marcospiana/termopago/docs/TermoPago_Proyecto_Completo.docx

TermoPago

Documento maestro del proyecto — v2

Contexto completo y actualizado para retomar en una conversación nueva.

Actualizado: agosto 2026 · Autor: Marcos — Concordia, Entre Ríos

Backend: web-production-94bbab.up.railway.app · Dominio: termopago.com.ar

Repo (público): github.com/marcospiana/termopago · Mail: contacto@termopago.com.ar

# Contenido

# 1. Qué es TermoPago

Sistema IoT de cobro que activa máquinas de autoservicio cuando el cliente paga con un QR de MercadoPago. El cliente escanea el QR pegado en la máquina, paga desde el celular (cualquier billetera/app bancaria), y el equipo arranca solo por el tiempo pagado, sin cajero ni efectivo.

Sirve para aspiradoras, sopladores, termos, infladores, lavaderos — cualquier equipo que se active por tiempo o por pulso. Convive con las fichas (no reemplaza el monedero: le suma un medio de pago).

Estado: funcionando con pagos reales. Termo + 2 estaciones (aspiradora + soplador cada una). El circuito pago → activación funciona; el QR se re-arma solo; hay reembolso automático y respaldo por fichas.

# 2. Arquitectura ACTUAL: maestro–esclavo (2 ESP)

El cambio más importante desde la v1. Cada estación se divide en dos ESP para que un servicio pago NUNCA se corte por problemas de WiFi:

- MAESTRO (ESP32): solo hace WiFi + backend. Poll ea los pagos y, cuando entra uno, le manda al esclavo por UART el comando "activá canal X por Y segundos". NO tiene relé ni LCD, así que no se puede colgar por el bus del display.
- ESCLAVO (ESP32 o ESP8266): maneja el RELÉ, el TIEMPO del servicio y el CONTADOR en pantalla. Cuenta el tiempo con su propio reloj. Como no hace WiFi, casi nunca se reinicia — y si el maestro pierde WiFi o se reinicia, el esclavo SIGUE dando el servicio hasta el final.

Enlace entre los dos: un cable UART (TX del maestro → RX del esclavo) + GND común. El maestro va afuera (buena señal); el esclavo va en la máquina (con el relé y el display).

## Protocolo maestro → esclavo (UART, 9600)

- "1<texto>" / "2<texto>": líneas del display en REPOSO (las manda el maestro).
- "A,<canal>,<seg>,<orden>": ACTIVAR un canal. El esclavo ignora un orden repetido (dedup), así un reinicio del maestro no re-activa el mismo pago.

El display en servicio lo dibuja el ESCLAVO (tiene el temporizador); en reposo muestra el texto del maestro.

# 3. Firmware — archivos y qué hace cada uno

Carpeta (firmware/) | Qué es
estacion01_maestro | ESP32 maestro est.01 (IDs aspiradora01/soplado01). Incluye BSSID-lock a 2.4GHz de Home3523.
estacion01_esclavo | NodeMCU ESP8266: relé + display + tiempo. RX=D7, relés D5/D6, LCD SDA=D2/SCL=D1.
estacion02_maestro | ESP32 maestro est.02 (IDs aspiradora02/soplado02).
estacion02_esclavo | ESP32: relé + display + tiempo. RX=GPIO16, relés 25/26, LCD 21/22.
prueba_1esp_busclear | Variante de UN ESP (LCD por I2C a 2m con bus-clear). Guardada para prueba futura.
test_lcd_esp8266 | Diagnóstico: escáner I2C + test de LCD para el ESP8266.
test_scan_wifi | Diagnóstico: escanea redes 2.4GHz (BSSID/canal/RSSI) desde el lugar.
termopago_esp32_v3 | Firmware del TERMO (1 relé + LCD, un solo ESP).

## Conexiones maestro–esclavo (recordatorio)

- Est.02 (2x ESP32): maestro GPIO17 → esclavo GPIO16; GND común. Relés en el esclavo GPIO25/26. LCD al esclavo SDA21/SCL22.
- Est.01 (ESP32 + ESP8266): maestro GPIO17 → esclavo D7(GPIO13); GND común. Relés en el esclavo D5(GPIO14)/D6(GPIO12). LCD SDA=D2(GPIO4)/SCL=D1(GPIO5).
- IMPORTANTE: fuente 5V SEPARADA para el esclavo (solo GND en común), + cap 3300µF + 0.1µF en cada ESP.

# 4. Fixes de confiabilidad aplicados

- Watchdog que SÍ reinicia: se usa esp_task_wdt_reconfigure con trigger_panic (antes solo avisaba, no reseteaba). Comprobado: rescata cuelgues reales.
- Se quitó el watchdog por timer: causaba reinicios cada 90s (833 'Watchdog interrupt' en /reinicios). Eliminado.
- Reconexión WiFi sin portal: si pierde WiFi, reintenta la red guardada y reinicia limpio; nunca queda esperando configuración (era lo que lo dejaba muerto).
- Doble consulta: recién tras 2 ciclos de polling fallados muestra 'Sin conexión al servidor' (evita el parpadeo por un bache).
- LCD robusto: reintento de init al arrancar + recuperación física del bus I2C (9 pulsos) + reinit diferido tras conmutar el relé + Wire.setTimeOut.
- HTTPS: setInsecure + connect timeout, para que un server caído no cuelgue el equipo.
- BSSID-lock (est.01): clavado a la radio 2.4GHz del router doble banda para evitar el band-steering a 5GHz (que hacía colgar y reiniciar). LOCK_BSSID + LOCK_CHANNEL en el maestro.

# 5. Backend (app.py)

- Flask + gunicorn en Railway. app.py en la RAÍZ (Railway deploya de ahí). PostgreSQL. Deploy automático desde main.
- Zona horaria AR (UTC-3) con ahora_ar() en todo.
- MercadoPago Orders API v1. QR estático por caja. Orden vence PT15M, se re-arma con el polling.
- Reembolso automático de pagos no atendidos (~5 min). Retoma con tiempo restante tras corte de luz. Monto mínimo QR: $50.

## Variables en Railway

Variable | Contenido
MP_ACCESS_TOKEN | Token de la cuenta propia (termo)
MP_TOKEN_ASPIRADORA | Token del cliente de las estaciones
CLAVE_SECRETA | Clave de las URLs del panel
PRECIO / DATABASE_URL | Precio por defecto / PostgreSQL
MP_CLIENT_ID / SECRET / FEE_PORCENTAJE | Futuras: OAuth marketplace (comisión)

# 6. Páginas del panel de control

Reemplazar TU_CLAVE por CLAVE_SECRETA. Base: web-production-94bbab.up.railway.app (o termopago.com.ar).

Página | URL | Para qué
Estado | /estado/TU_CLAVE | Estado en vivo de cada equipo (verde/amarillo/rojo)
Cortes | /cortes/TU_CLAVE | Bajones de conexión >30s por día
Reinicios ⭐NUEVO | /reinicios/TU_CLAVE | Por qué se reinició cada ESP (watchdog/pico/corte/WiFi) + cuánto estuvo activo + ID del equipo
Historial | /historial/TU_CLAVE | Movimientos: día, hora, máquina, monto, estado
Estadísticas | /estadisticas/TU_CLAVE | Ventas por día, mes y máquina
Config | /config/TU_CLAVE | Precio y tiempo de cada máquina
Simular pago | /simular_pago/TU_CLAVE/SEG/ID | Prueba sin dinero
Re-armar QR | /rearmar/TU_CLAVE/ID | Re-armar un QR vencido
Crear máquina | /crear_dispositivo/TU_CLAVE/ID/NOMBRE/VAR_TOKEN | Alta de una máquina nueva
Diagnóstico | /diagnostico/TU_CLAVE | Credenciales MP, cajas, datos crudos
Landing | / | Página pública (clientes)

/reinicios y /boot: el ESP reporta al arrancar en /boot/<id>/<motivo> (esp_reset_reason). La página /reinicios muestra la causa (corte-luz, software, wdt-task, brownout-elec, etc.) con el ID del equipo (aspiradora01 vs aspiradora02) para distinguir estaciones.

# 7. Diagnóstico y aprendizajes clave

- Est.01 se reiniciaba por band-steering: el router Home3523 (doble banda) la empujaba a 5GHz → la WiFi se volvía inestable → se colgaba. Solución: clavar el ESP a la radio 2.4GHz por BSSID. RESUELTO.
- Est.02 tiene señal floja (-75 dBm) vía repetidor: el repetidor (TP-Link TL-WR850N, solo 2.4) está lejos. Solución pendiente: acercar el repetidor / antena externa (WROOM-32U) / módulo 4G.
- Display en blanco al conectar WiFi = ALIMENTACIÓN: el tirón de corriente del WiFi baja la tensión de la fuente compartida y apaga el esclavo/LCD. Solución: fuente 5V SEPARADA por ESP + cap 3300µF + 0.1µF pegados a cada ESP.
- Cuelgue al apagar la máquina = pico de la bobina del contactor: solución: snubber RC en las bobinas (A1-A2). Un MOV ayuda pero no alcanza solo.
- La instrumentación (/reinicios) es oro: permite ver la causa exacta de cada falla en vez de adivinar. Fue lo que localizó el bug del watchdog por timer.

# 8. Máquinas activas

Máquina | ID | Caja MP | Relé | Estación
Termo | termo_001 | 1486831 | — | Propia (sin ESP por ahora)
Aspiradora 01 | aspiradora01 | 135130132 | canal 0 | Est.01 (Home3523)
Soplador 01 | soplado01 | 135136662 | canal 1 | Est.01
Aspiradora 02 | aspiradora02 | 135700091 | canal 0 | Est.02 (repetidor)
Soplador 02 | soplado02 | 135700133 | canal 1 | Est.02

# 9. Cómo armar un dispositivo para OTRO cliente

Pasos completos para sumar una estación de un cliente nuevo:

1. MercadoPago del cliente: el cliente crea su aplicación en MP y te pasa su Access Token. (Vos no ingresás sus credenciales en ningún lado por él.)
2. Cargar el token en Railway como una variable nueva (ej. MP_TOKEN_CLIENTEX). NUNCA en el código (el repo es público).
3. Crear la(s) máquina(s) en el backend: /crear_dispositivo/TU_CLAVE/ID/NOMBRE/MP_TOKEN_CLIENTEX. Devuelve la caja MP y el link del QR. El ID no debe tener espacios y debe coincidir con el firmware.
4. Imprimir el QR de cada máquina (el link que devuelve, o de /diagnostico) y pegarlo en la máquina.
5. Hardware por estación: 1 ESP32 (maestro) + 1 ESP32/ESP8266/Arduino Nano (esclavo) + módulo relé + LCD + 2 fuentes 5V (separadas) + caps 3300µF+0.1µF + snubbers en las bobinas + caja IP65.
6. Firmware: copiá estacion0X_maestro y estacion0X_esclavo, cambiá los IDs por los del cliente y el nombre del portal WiFi. Si la red del cliente es doble banda, poné el BSSID-lock (escaneá con test_scan_wifi para sacar BSSID/canal).
7. Cargar el maestro (ESP32 Dev Module) y el esclavo. Conectar según el mapa de pines. Configurar el WiFi (portal WiFiManager la primera vez).
8. Probar: simular un pago (/simular_pago) y verificar que el relé active y el contador aparezca. Después, un pago real.
9. Comisión (opcional): activar OAuth marketplace cuando corresponda (MP_CLIENT_ID/SECRET/FEE_PORCENTAJE + /oauth_callback).

Checklist eléctrico anti-cuelgue: fuente separada para el esclavo, caps pegados, snubber en cada bobina de contactor/electroválvula, cableado de señales lejos de los 220V, gabinete a tierra.

# 10. Futuro: arquitectura LoRa (sitios con varias máquinas)

Para un sitio con varias máquinas separadas (sin cablear), la evolución natural del maestro-esclavo: UNA central con internet que le avisa a cada máquina por radio LoRa. Elimina el WiFi por equipo.

- Central (1 por sitio): ESP32 con internet (Ethernet vía WT32-ETH01, o 4G, o WiFi) + LoRa 915MHz. Poll ea/escucha el backend y reparte comandos por LoRa.
- Nodos (1 por máquina): ESP32/Arduino + módulo LoRa 915MHz + relé + TU LCD (no hace falta la OLED). Es el mismo esclavo, con LoRa en vez de UART y un ID de nodo.
- Placa recomendada: Heltec WiFi LoRa 32 V3 (915MHz) — ESP32+LoRa+OLED integrados. O ESP32/Arduino + módulo SX1262 915MHz si querés sin pantalla.
- Direccionamiento: cada nodo tiene un ID; el comando lleva el ID destino (A|nodo|canal|seg|orden); cada nodo filtra por su ID.
- ACK: LoRa es bidireccional → el nodo confirma que recibió la orden; el maestro reintenta si no hay ACK, y recién ahí confirma el pago (/completar). Cierra el hueco de 'plata sin servicio'. + heartbeat para el estado en vivo.
- Push en vez de polling: con MQTT, MercadoPago avisa al backend (webhook) y el backend publica el pago → la central lo recibe al instante, sin preguntar cada 3s. (+ poll de respaldo cada 30-60s.)
- 50m entre estaciones = trivial para LoRa. 1 central + N nodos, todas placas iguales.

# 11. Seguridad y pendientes

- Tokens y CLAVE_SECRETA SOLO en variables de Railway, nunca en el código (repo público). El BSSID en el código no es secreto (es una MAC visible).
- ACCESOS_privado.txt / *_privado.txt en .gitignore, NUNCA se comitean. Gestor de contraseñas pendiente (Bitwarden).
- Pendientes est.02: fuente separada + caps, señal (repetidor/antena/4G), snubbers.
- Pendientes generales: activar OAuth marketplace; estadísticas propias del cliente; recargo por crédito (listo para agregar); prototipo LoRa cuando lleguen las placas.

# 12. Cómo continuar en una conversación nueva

Subí este .docx al inicio de la conversación nueva y pegá algo así:

Estoy desarrollando TermoPago: sistema IoT que activa máquinas de autoservicio (aspiradoras, sopladores) al pagar con QR de MercadoPago. Backend Flask en Railway con PostgreSQL; los equipos son ESP32 en arquitectura maestro-esclavo (el maestro hace WiFi+backend, el esclavo maneja relé+tiempo+display, así el servicio no se corta si el maestro pierde WiFi). Te adjunto el documento maestro con TODO el contexto (arquitectura, firmware, fixes, páginas del panel, cómo armar para un cliente nuevo, y el plan LoRa). Leélo y ayudame a seguir con: [DECIME EN QUÉ AVANZAR].

No olvidar: tokens y clave SOLO en Railway (repo público); app.py en la raíz; fuente separada + caps + snubber en cada estación nueva.
