marcospiana/termopago/docs/TermoPago_Resumen_Tecnico.docx

TermoPago

Sistema de cobro automático para servicios físicos

Marcos Piana — Concordia, Entre Ríos — Mayo 2026

# ¿Qué es TermoPago?

Sistema IoT que permite cobrar automáticamente por servicios físicos (agua caliente, inflado, aspirado) mediante un código QR y MercadoPago. El cliente escanea el QR con la cámara del celular, paga, y el relé se activa automáticamente por el tiempo configurado. Sin atención humana requerida.

# Arquitectura del sistema

## Flujo completo

• Cliente escanea QR físico con la cámara del celular

• QR apunta a: https://web-production-94bbab.up.railway.app/crear_pago

• El backend Flask genera una preferencia de pago en MercadoPago y redirige

• Cliente paga con débito o cuenta MercadoPago

• MercadoPago envía un webhook POST al backend con la confirmación

• Backend guarda una orden pendiente en la base de datos

• El ESP8266 consulta el backend cada 3 segundos vía HTTP GET

• Si hay orden pendiente → activa el relé por el tiempo configurado

• El LCD muestra cuenta regresiva en tiempo real

## Stack tecnológico

Componente | Tecnología / Detalle
Microcontrolador | NodeMCU ESP8266 (migración a ESP32 pendiente)
Backend | Python Flask hosteado en Railway
Base de datos | SQLite (migración a PostgreSQL pendiente)
Pagos | MercadoPago — solo débito y cuenta MP
Display | LCD 16x2 con I2C (hd44780 de Bill Perry, dirección 0x27)
Relé | 1 canal, lógica invertida (LOW=ON, HIGH=OFF)
WiFi setup | WiFiManager — red 'TermoPago' para configurar sin código
QR | Generado en goqr.me — URL fija, nunca cambia
Repositorio | github.com/marcospiana/termopago

# Hardware

## Componentes actuales

Componente | Detalle
NodeMCU ESP8266 | Microcontrolador principal
Relé 1 canal | Lógica invertida. Conectado a 3.3V (no VIN — causa activación involuntaria)
LCD 16x2 I2C | Dirección 0x27. Alimentado con 5V externo, NO del NodeMCU
Fuente 5V externa | Para el LCD

## Conexiones

Relé: IN → D1 | VCC → 3.3V | GND → GND

LCD: VCC → 5V externo | GND → GND | SDA → D2 | SCL → D3

## Hardware pendiente de compra

• ESP32 DevKit V1 38 pines — reemplaza el ESP8266

• Relé con optoacoplador 5V 1 canal

• Fuente industrial 220V → 5V 2A

• Buck converter LM2596 (para alimentar desde 24V)

• Caja estanca IP65 + borneras atornillables

• Buzzer activo 5V (beep al activarse el servicio)

• DFPlayer Mini + parlante + microSD (audio futuro)

• Waveshare ESP32-S3 Relay 6CH (para múltiples servicios)

# Backend Flask

## URL de producción

https://web-production-94bbab.up.railway.app

## Rutas disponibles

Ruta | Descripción
GET /orden/<dispositivo_id> | El ESP consulta si hay orden pendiente. Retorna encender y segundos
GET /simular_pago/termo2026$ | Simula un pago aprobado para pruebas
POST /webhook | Recibe notificaciones de MercadoPago
GET /crear_pago | Genera preferencia de pago y redirige al checkout de MP
GET /historial | Últimas 20 órdenes ejecutadas

## Variables de entorno en Railway

Variable | Descripción
MP_ACCESS_TOKEN | Token productivo de MercadoPago (APP_USR-...)
CLAVE_SECRETA | termo2026$ — protege la ruta de simulación de pago
PRECIO | 500 (ARS, configurable sin tocar código)

# Problemas de confiabilidad identificados

## 🔴 Crítico — SQLite en Railway

Railway borra la base de datos en cada redeploy. Una orden pendiente puede desaparecer antes de que el ESP la ejecute, causando que el cliente pague y el servicio no se active.

Solución: Migrar a PostgreSQL integrado de Railway (pendiente).

## 🟡 Importante — Firmware del ESP

• Sin watchdog timer: si el ESP se cuelga, no se recupera solo

• Sin lógica de reconexión WiFi: si cae el WiFi, el loop sigue sin hacer nada

• Posible memory leak: http.getString() sin liberar puede colgar el dispositivo después de horas

## ✅ Lo que ya está bien

• Polling cada 3 segundos es robusto y simple — no se cambia a WebSockets por priorizar confiabilidad

• WiFiManager permite reconfigurar WiFi sin tocar el código (resetear: RST x3 en menos de 10 segundos)

• Webhook de MercadoPago es el mecanismo confiable de notificación de pagos

• QR definitivo — la URL nunca cambia aunque cambie el precio

# Decisiones de arquitectura tomadas

Decisión | Razonamiento
Polling 3s en vez de WebSockets | Simplicidad y tolerancia a fallos. La latencia de 3s es aceptable para un servicio de 30 minutos
ESP32 en vez de Raspberry Pi | RPi puede corromper la SD en cortes de luz. ESP32 arranca en 2 segundos y es más confiable 24/7
Flask + Railway en vez de serverless | Webhook de MP requiere servidor persistente, no funciones efímeras
SQLite → PostgreSQL | SQLite en Railway no es persistente entre deploys. PostgreSQL es obligatorio para producción
Solo débito y cuenta MP | Elimina el riesgo de pagos en efectivo (rapipago, pagofacil) que complican el flujo

# Modelo de negocio

• El dueño del local instala y paga el hardware (~$50-80 USD)

• Marcos instala, configura y cobra comisión por transacción (5-10%)

• Implementación futura: MercadoPago Marketplace — el cliente autoriza su cuenta via OAuth

• Split automático del pago: X% para el local, Y% para Marcos

• Facturación automática futura via API de AFIP

# Próximos pasos priorizados

## Corto plazo

• Migrar SQLite → PostgreSQL en Railway (CRÍTICO)

• Agregar watchdog timer al firmware del ESP

• Agregar reconexión WiFi automática en el loop

• Cambiar 10 segundos a 30 minutos reales en producción

• Agregar buzzer activo

## Mediano plazo

• Migrar código a ESP32 cuando llegue el hardware

• Integrar MercadoPago Marketplace para cobro de comisión

• Agregar segundo dispositivo (infladora/aspiradora)

• Panel web de administración

## Largo plazo

• WebSockets — reemplazar polling (para cuando haya múltiples dispositivos)

• DFPlayer Mini — audio 'Servicio activado'

• Waveshare ESP32-S3 6CH — instalaciones con múltiples servicios

• Facturación automática

# Repositorio

Ítem | Detalle
GitHub | github.com/marcospiana/termopago
Branch | main
Archivos clave | app.py, Procfile, requirements.txt, termopago/termopago.ino
