marcospiana/termopago/template_2a4dd50156a34a58b650aa6e8b9947af78a9d610c6074fe3ac053d378037efce.pdf

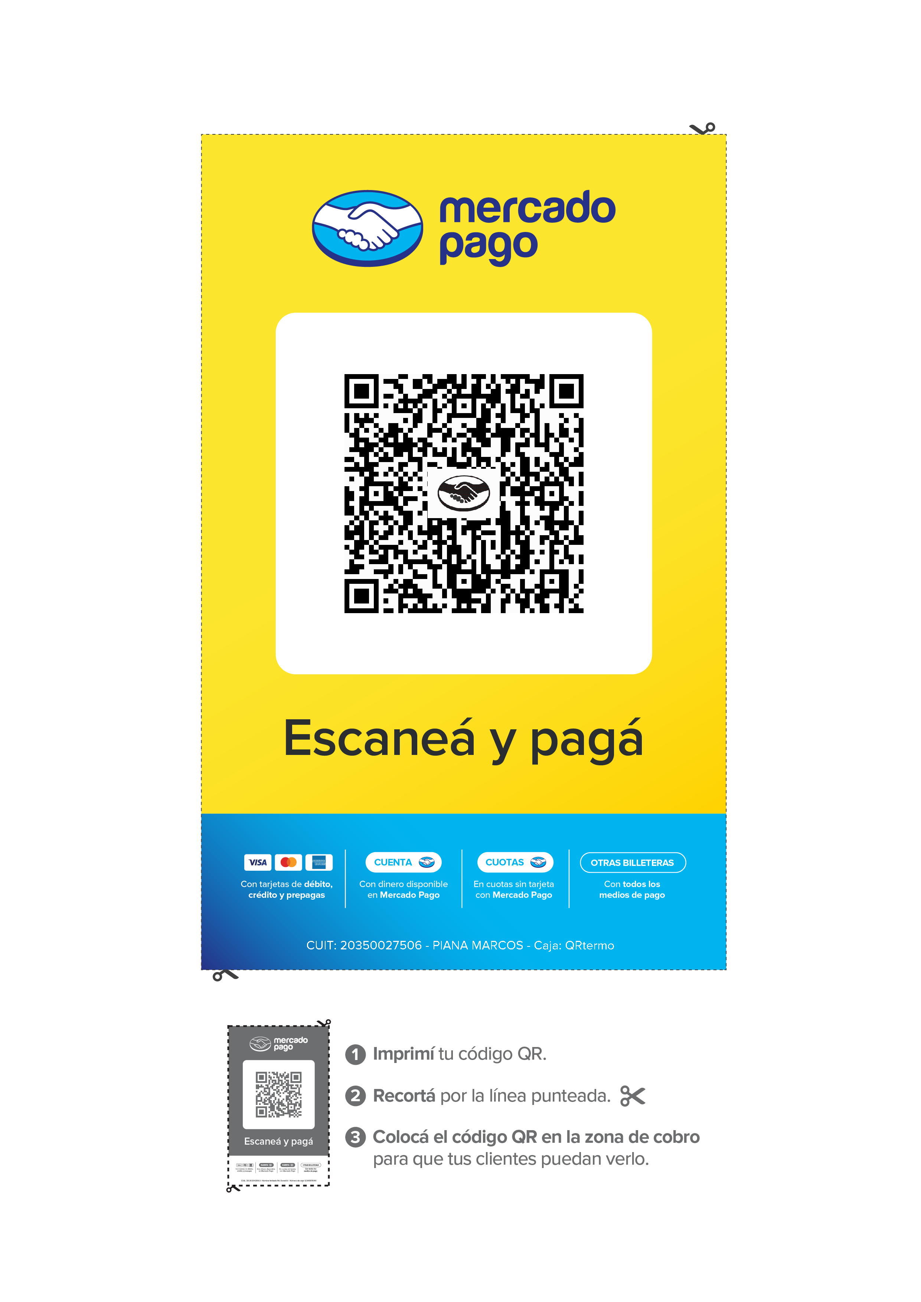
[picture p1: page 1]
