marcospiana/termopago/carteles/cartel_villagas01_bilingue_12x17.pdf

# FICHAS

Pagá con tu celular y llevate tu ficha Pague com o celular e retire sua ficha

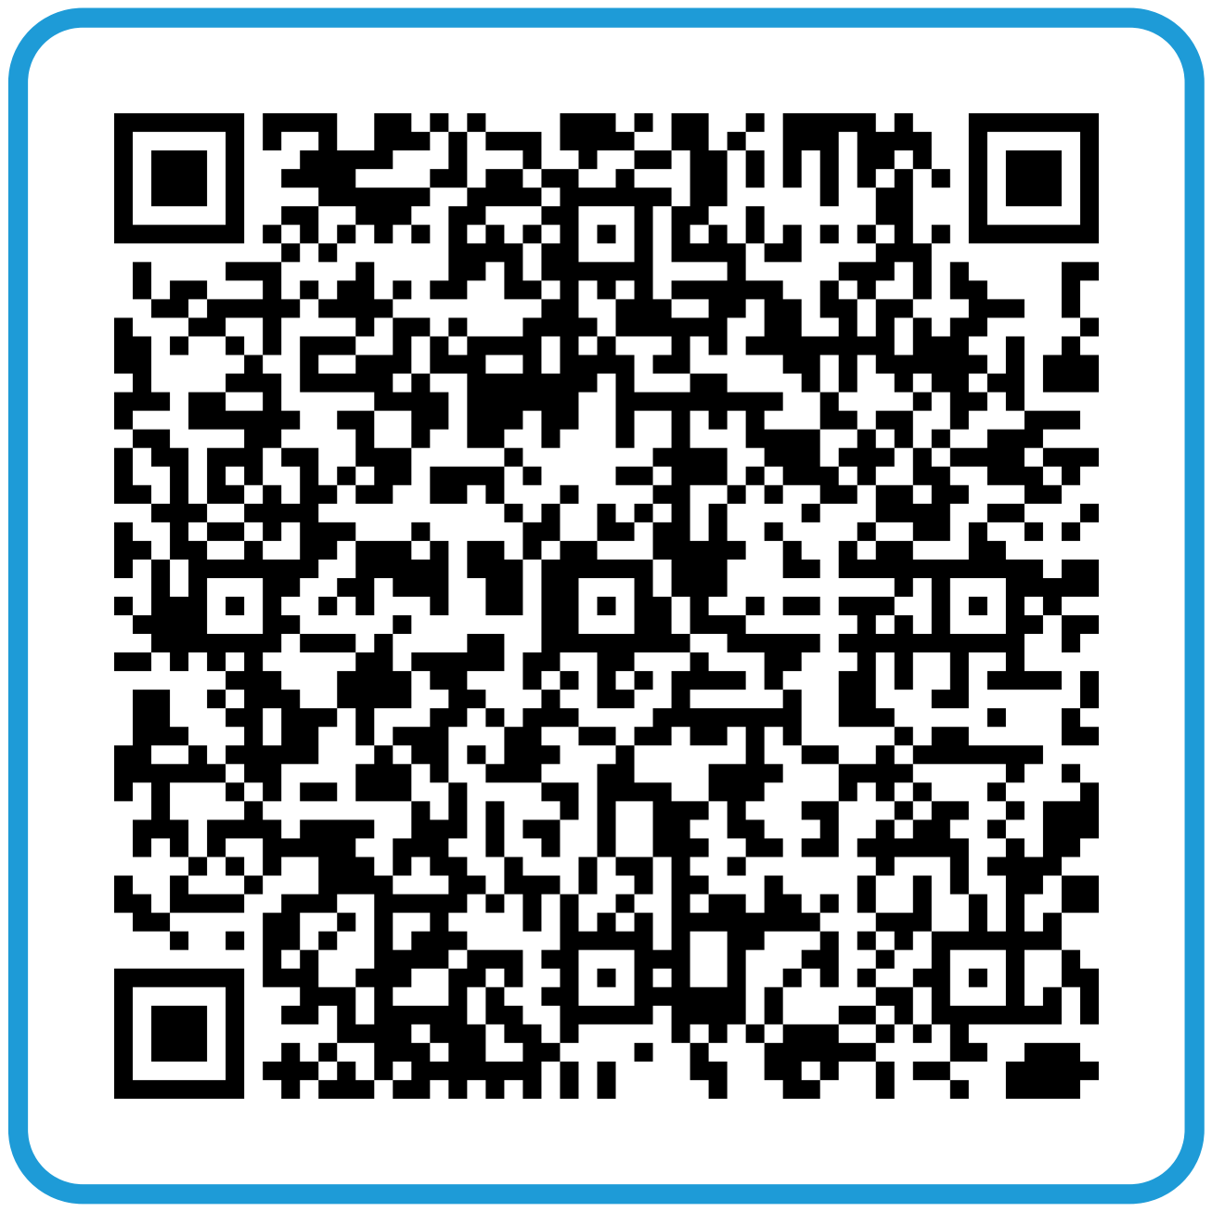
[picture p2: figure]

Escaneá con Mercado Pago o tu billetera virtual Escaneie com Mercado Pago ou sua carteira digital MODO · Cuenta DNI · Ualá · y otras

### 1 Abrí tu billetera virtual

Abra sua carteira digital

### 2 Tocá "Pagar con QR" y escaneá el código

Toque em "Pagar com QR" e escaneie o código 3 ¡Listo! Retirá tu ficha
Pronto! Retire sua ficha

### 1 pago = 1 ficha · 1 pagamento = 1 ficha

Pagos procesados por Mercado Pago · Sistema TermoPago
