marcospiana/termopago/qr/expendedora de fichas villagas.pdf

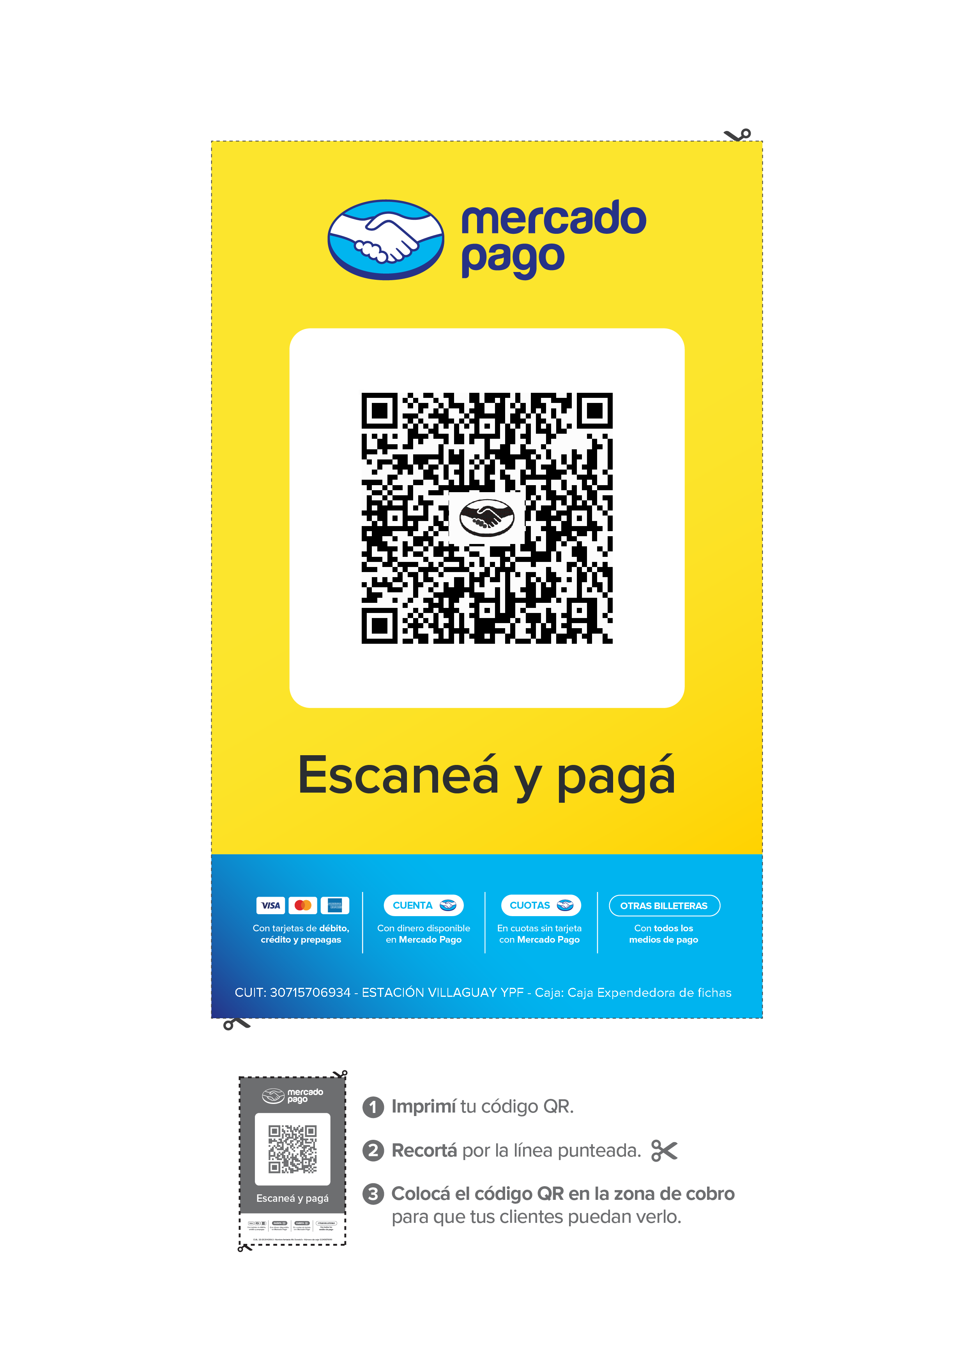
[picture p3: page 1]
