marcospiana/termopago/carteles/cartel_aspiradora01.pdf

# ASPIRADORA

Pagá con tu celular y usála al instante

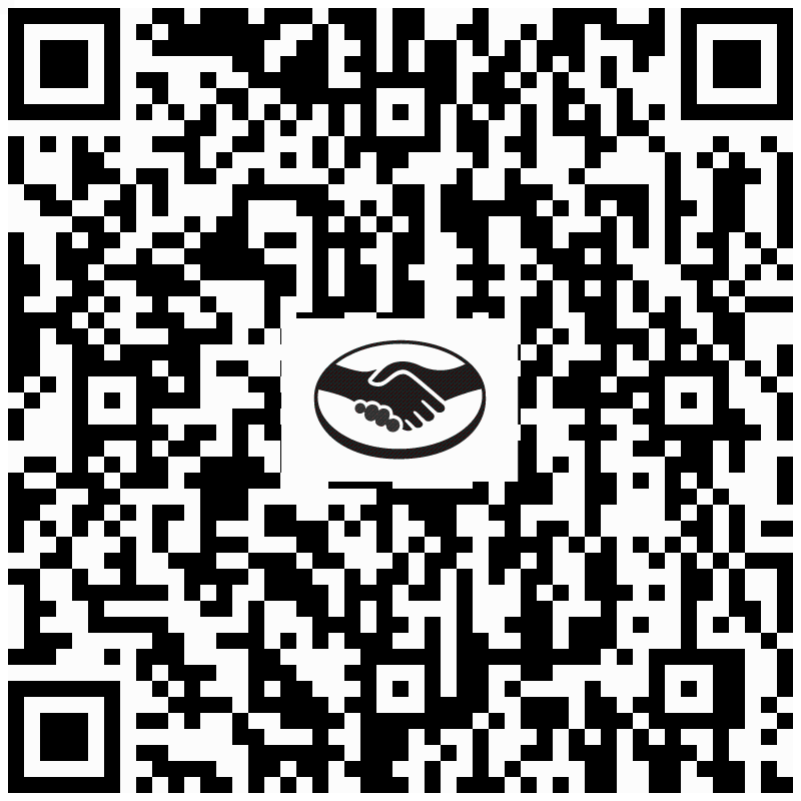
[picture p4: figure]

Escaneá con Mercado Pago o tu billetera virtual
MODO · Cuenta DNI · Ualá · y otras

### 1 Mirá la pantalla: debe decir "WiFi conectado"

### 2 Abrí tu billetera virtual

### 3 Tocá "Pagar con QR" y escaneá el código

4 ¡Listo! La máquina arranca sola

El tiempo restante se muestra en la pantalla del equipo

También funciona con fichas: conseguilas en el Full

Pagos procesados por Mercado Pago · Sistema TermoPago
