marcospiana/termopago/_viejo/aspiradora01.pdf

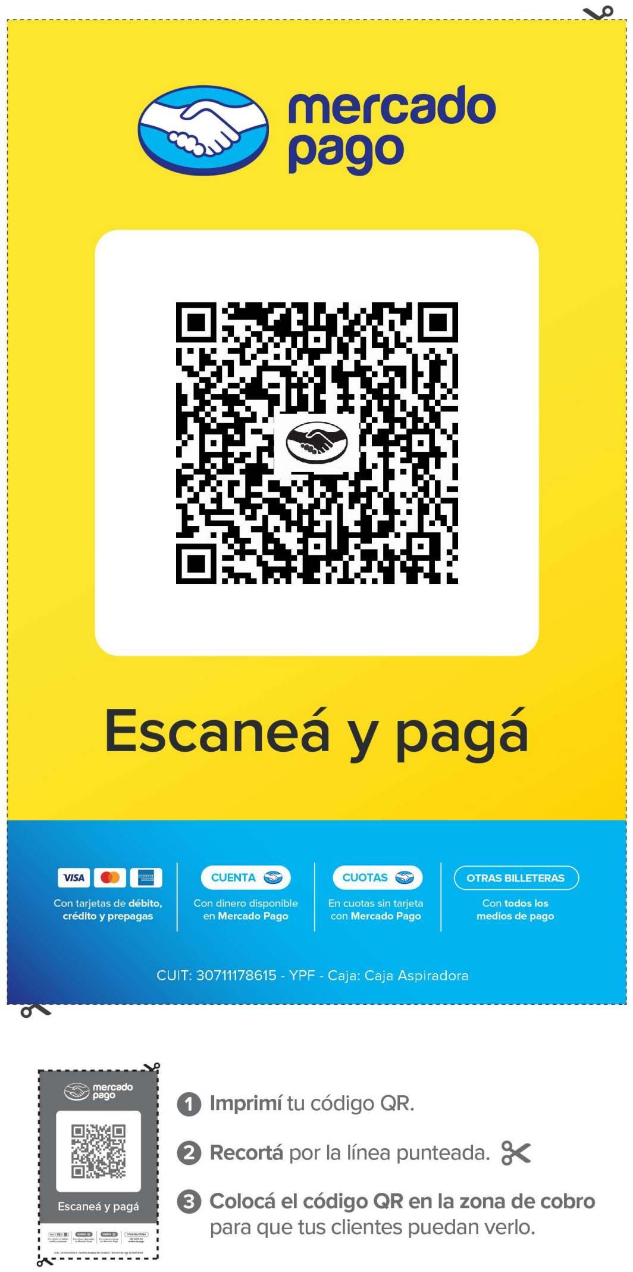
[picture p5: page 1]
