marcospiana/termopago/_viejo/soplado01.pdf

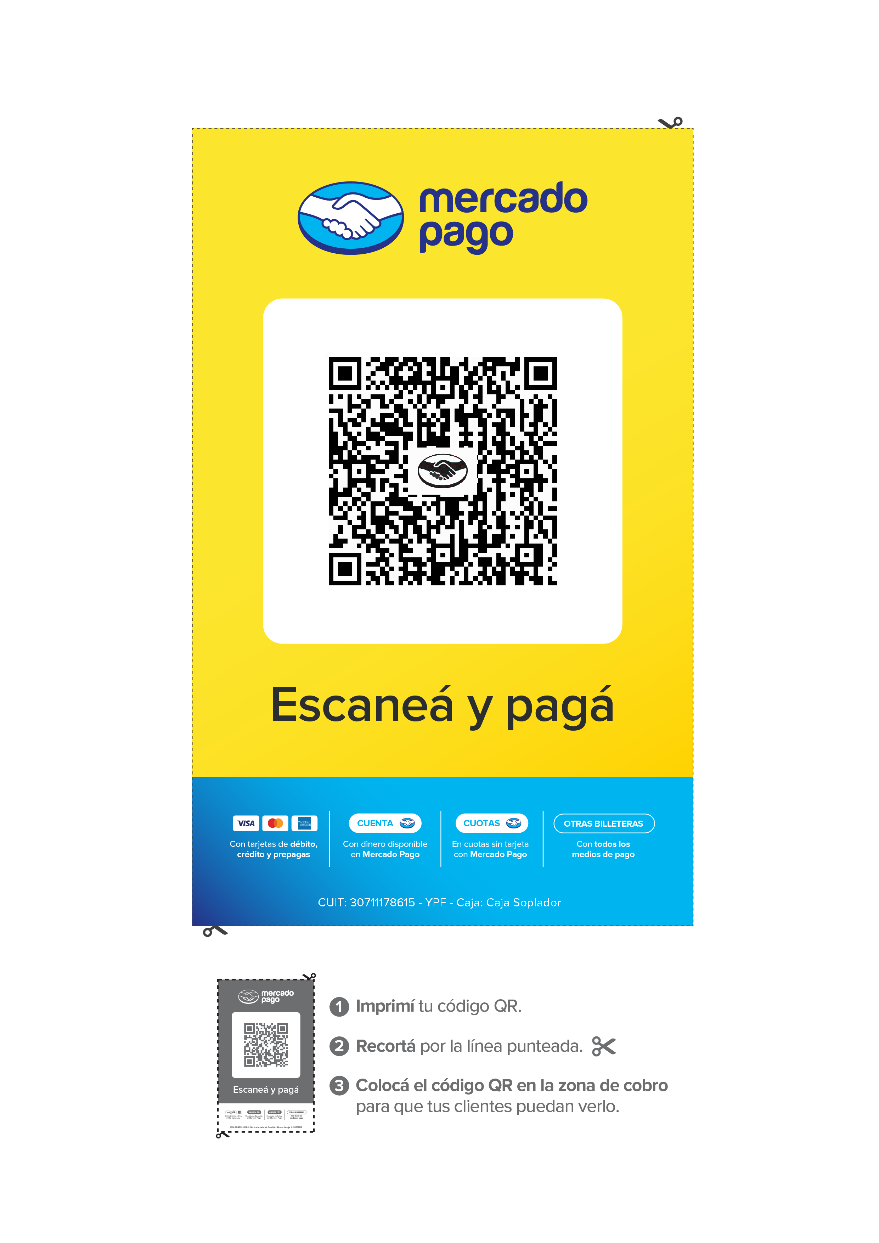
[picture p6: page 1]
