marcospiana/termopago/qr/aspiradora02.png

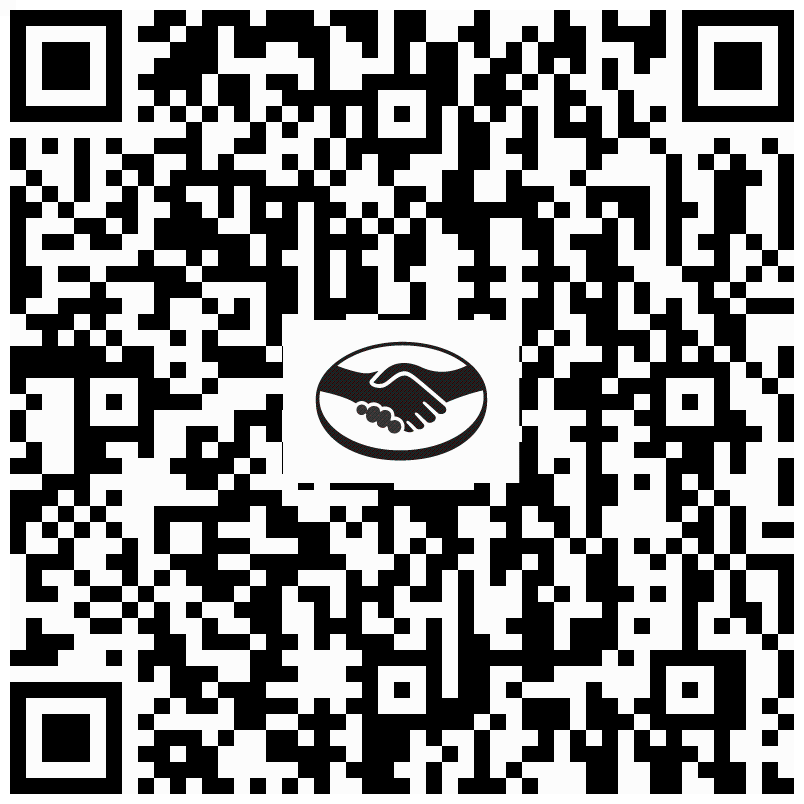
qr/aspiradora02.png
