marcospiana/termopago/qr/inflado01.png

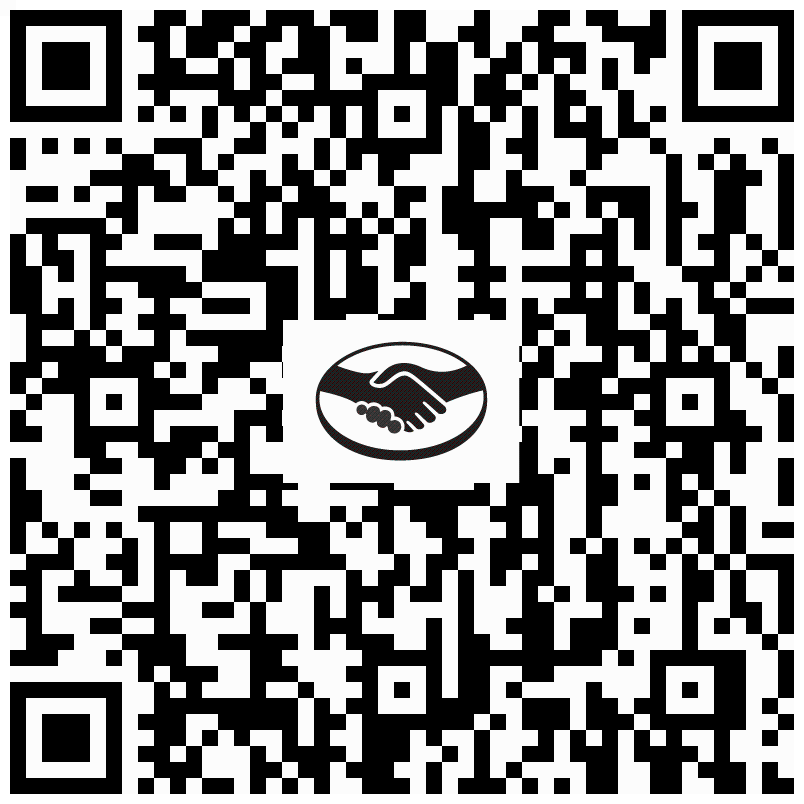
qr/inflado01.png
