marcospiana/termopago/qr/soplado01.png

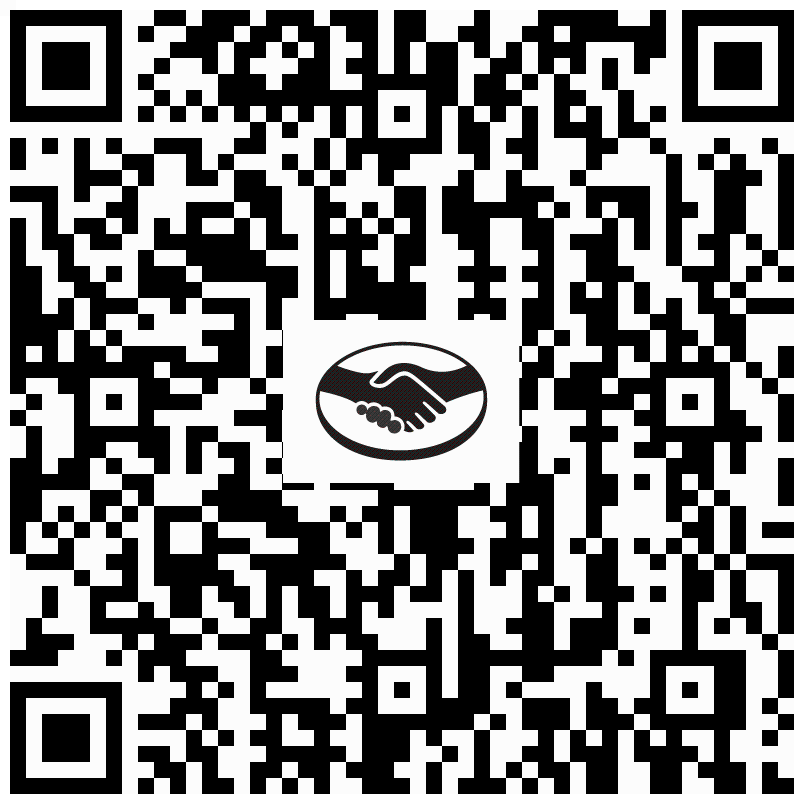
qr/soplado01.png
