marcospiana/termopago/qr/soplado02.png

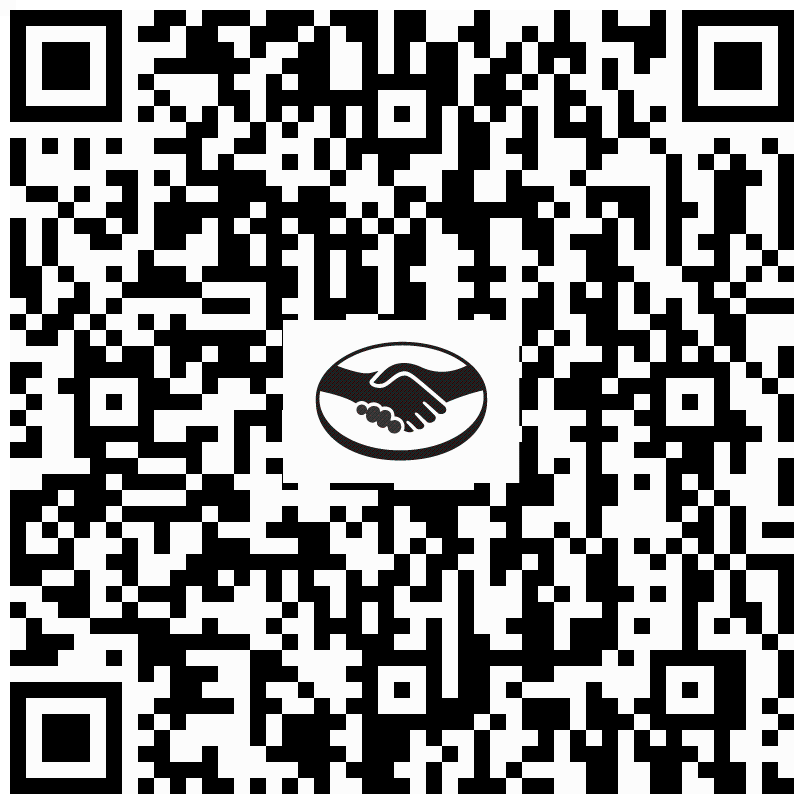
qr/soplado02.png
