marcospiana/termopago/qrtermopago.jpeg

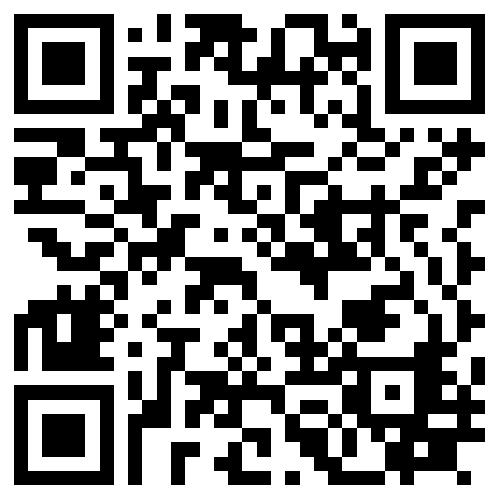
qrtermopago.jpeg
