marcospiana/termopago/carcasa_lcd_16x2/bezel_compacto.stl

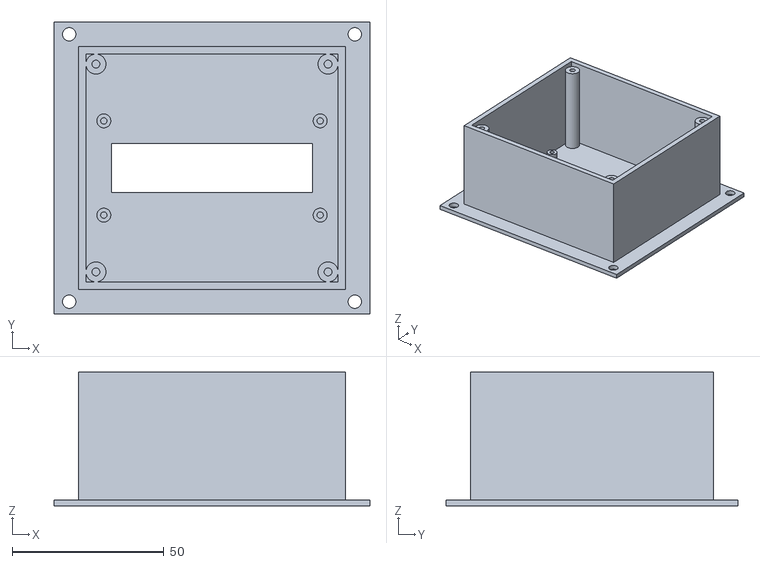
[picture p12: CAD file, 2026-08-05]
carcasa_lcd_16x2/bezel_compacto.stl
104.0 x 96.0 x 44.0
