marcospiana/termopago/carcasa_lcd_16x2/bezel_mini.stl

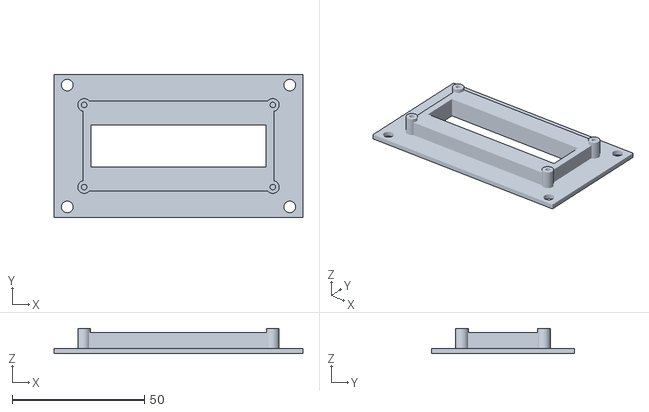
[picture p13: CAD file, 2026-08-05]
carcasa_lcd_16x2/bezel_mini.stl
94.0 x 54.0 x 9.50
