marcospiana/termopago/carcasa_lcd_16x2/tapa_compacta.stl

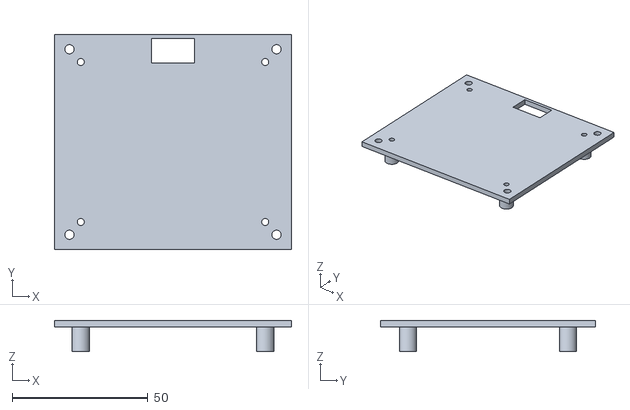
[picture p14: CAD file, 2026-08-05]
carcasa_lcd_16x2/tapa_compacta.stl
87.4 x 79.4 x 11.5
