marcospiana/termopago/carcasa_lcd_16x2/tapa_trasera.stl

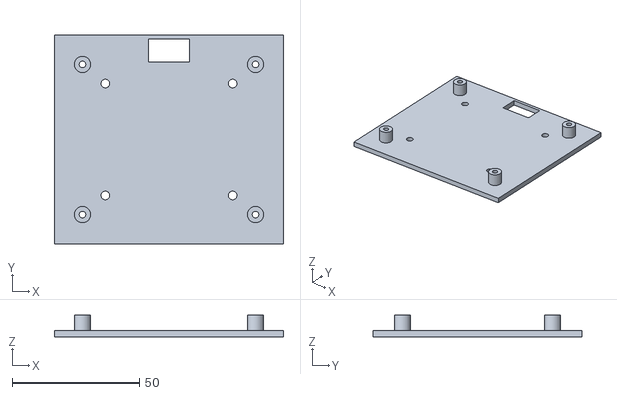
[picture p15: CAD file, 2026-08-05]
carcasa_lcd_16x2/tapa_trasera.stl
90.0 x 82.0 x 8.50
