marcospiana/termopago/carcasa_lcd_16x2/bezel_frontal.stl

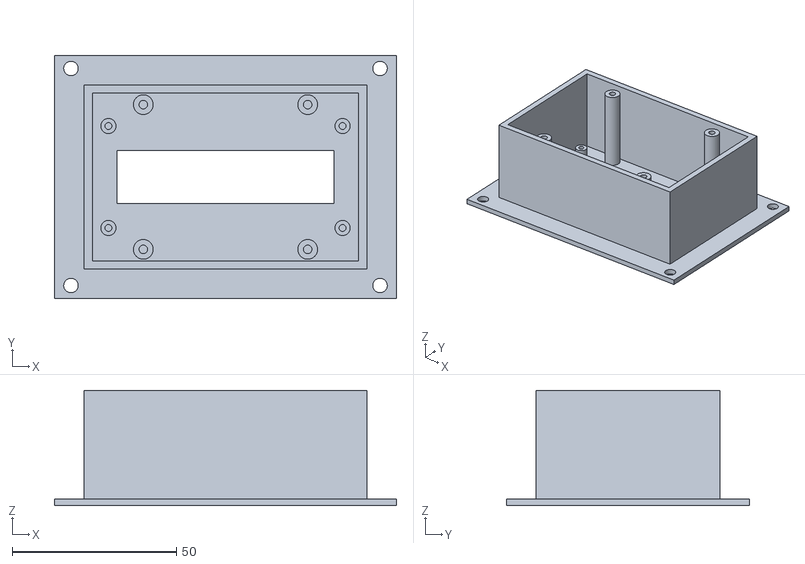
[picture p16: CAD file, 2026-08-05]
carcasa_lcd_16x2/bezel_frontal.stl
104.0 x 74.0 x 35.0
