marcospiana/termopago/_viejo/carcasa_frente.stl

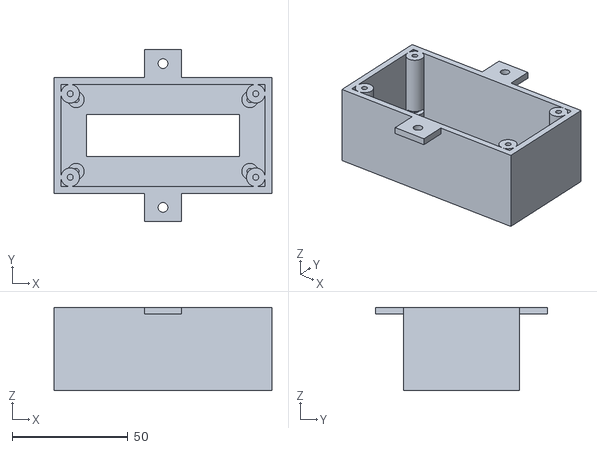
[picture p17: CAD file, 2026-08-05, an earlier design]
_viejo/carcasa_frente.stl
94.0 x 74.0 x 36.0
