marcospiana/termopago/docs/TermoPago_Instrucciones.docx

TermoPago

Sistema de cobro automático con MercadoPago

# 📱 Instrucciones para el cliente

Seguí estos pasos para usar el servicio:

1. Abrí la cámara de tu celular.
2. Escaneá el código QR que aparece en este cartel.
3. Se va a abrir el navegador y te redirige a MercadoPago.
4. Pagá con tu cuenta de MercadoPago o tarjeta de débito.
5. El servicio se activa automáticamente en segundos.
6. El display muestra el tiempo restante.

⚠️ Importante

• No uses la app de MercadoPago para escanear el QR.

• Usá la cámara nativa de tu celular (iPhone o Android).

• Solo se aceptan pagos con cuenta MercadoPago o tarjeta de débito.

• No se aceptan tarjetas de crédito ni pagos en efectivo.

# 🔲 Código QR


📷 Escaneá con la cámara de tu celular
