marcospiana/termopago/carteles/cartel_villagas01.pdf

# FICHAS

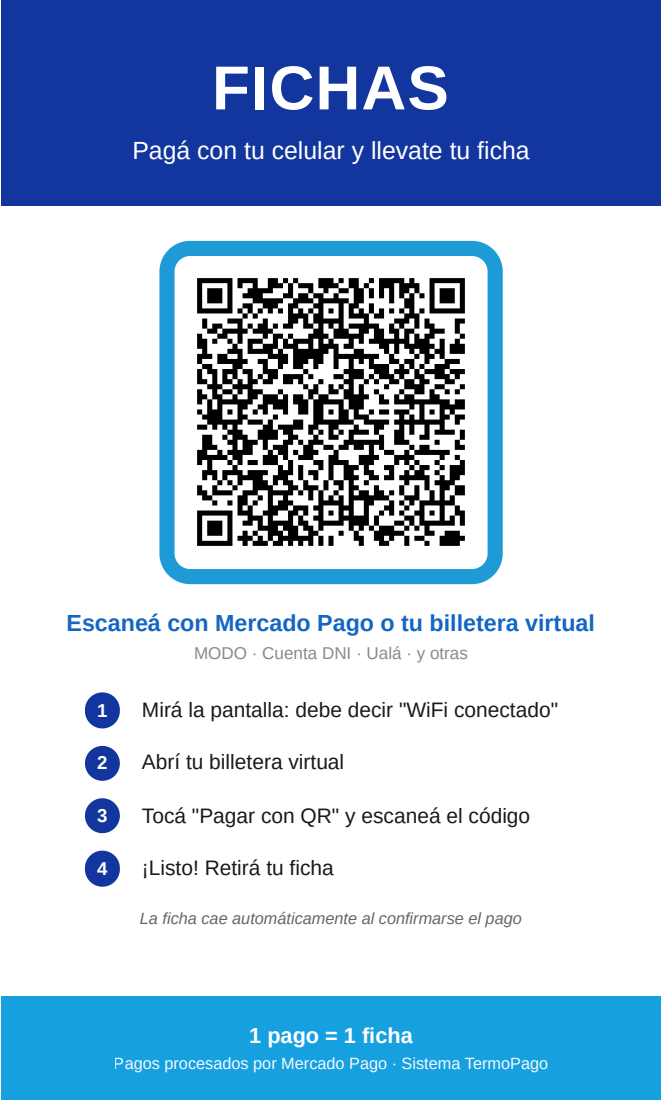
[picture p18: page 1]
1 pago = 1 ficha

Pagá con tu celular y llevate tu ficha

Escaneá con Mercado Pago o tu billetera virtual

MODO · Cuenta DNI · Ualá · y otras

1 Mirá la pantalla: debe decir "WiFi conectado"

2 Abrí tu billetera virtual

3 Tocá "Pagar con QR" y escaneá el código

4 ¡Listo! Retirá tu ficha

La ficha cae automáticamente al confirmarse el pago

Pagos procesados por Mercado Pago · Sistema TermoPago
