marcospiana/termopago/firmware/termopago_fichas/termopago_fichas.ino

/*  ============================================================================
    TermoPago — Expendedora de fichas (UNIVERSAL, placa Electrolacer)
    ----------------------------------------------------------------------------
    Un solo ESP32 (SIN esclavo). MQTT push sobre TLS.

    ESTE SKETCH ES EL MISMO PARA TODAS LAS EXPENDEDORAS DE FICHAS.
    No se edita nada para dar de alta una maquina nueva: el ID de caja
    (villagas01, lavadero03, ...) se carga UNA VEZ desde el portal WiFi y
    queda guardado en la NVS del ESP. El panel /admin del backend te dice
    que ID cargarle a cada equipo.
    Para cambiarlo: manten apretado BOOT durante los primeros 5 s del arranque
    -> borra WiFi + ID y vuelve a levantar el portal.
    ENTREGA (ver dispensador.h): DOS reles contra la placa Electrolacer.
      - Rele COIN  (GPIO 26): pulso de 100 ms a masa en la entrada COIN del
        conector de 3 pines. Con ENTRADA COIN = $0 en la placa, UN pulso acredita
        el valor de UNA ficha.
      - Rele BOTON (GPIO 25): en paralelo con el pulsador fisico. La placa
        acumula credito pero NO entrega sola: hay que apretar el boton.
      - Sensor     (GPIO 27): opto PC817 desde la linea SENSOR; cuenta cada ficha
        que cae y confirma la entrega antes de dar el pago por cumplido.
    Se entrega de a UNA ficha por vez (pulso COIN -> boton -> esperar sensor), sin
    bloquear el loop: MQTT y watchdog siguen corriendo durante toda la entrega.

    Hereda todas las mejoras de confiabilidad de las estaciones 01/02:
      - Watchdog esp_task_wdt con trigger_panic = true (reinicia de verdad).
      - Reinicio por "sin comunicacion" adaptado a MQTT.
      - Reinicio preventivo cada 6 h en reposo.
      - WiFiManager portal "TermoPago-setup" con auto-lock de BSSID (anti band-steering).
      - Ventana 5 s post-boot con boton BOOT para resetear credenciales.
      - BSSID lock opcional (LOCK_ON) para redes doble banda.
      - reportarBoot() con reintentos al backend (registra motivo de reinicio).
      - Chequeo de heap libre.
      - LCD 16x2 I2C robusto (recuperacion de bus, reinit periodico, reinit
        diferido tras conmutar el rele).

    SEGURIDAD (repo PUBLICO): las credenciales del broker MQTT y la URL del
    backend NO van en este archivo. Van en "secretos_privado.h" (en .gitignore).
    Copiá "secretos_privado.h.ejemplo" -> "secretos_privado.h" y completalo.

    Programado en Arduino IDE. Core: ESP32 (Espressif) 2.x o 3.x.
    Librerias necesarias (Gestor de librerias):
      - WiFiManager (tzapu)
      - PubSubClient (Nick O'Leary)
      - ArduinoJson (Benoit Blanchon) v6 o v7
      - hd44780 (Bill Perry)   -> para el LCD I2C
    ============================================================================ */

#include <WiFi.h>
#include <WiFiClientSecure.h>
#include <WiFiManager.h>          // tzapu
#include <PubSubClient.h>         // Nick O'Leary
#include <ArduinoJson.h>          // Benoit Blanchon
#include <Preferences.h>          // NVS (dedup persistente)
#include <HTTPClient.h>
#include <esp_task_wdt.h>
#include <esp_system.h>

// ---- LCD 16x2 I2C (hd44780) ----
#include <Wire.h>
#include <hd44780.h>
#include <hd44780ioClass/hd44780_I2Cexp.h>

// ---- Secretos (NO se commitea) ----
#include "secretos_privado.h"
#include <time.h>              // configTime/time() para validar el cert TLS
#include "ca_hivemq.h"        // raices CA de Lets Encrypt (ISRG X1/X2)
/*  secretos_privado.h debe definir:
      #define MQTT_HOST     "xxxxx.s1.eu.hivemq.cloud"
      #define MQTT_PORT     8883
      #define MQTT_USER     "usuario_del_broker"
      #define MQTT_PASS     "password_del_broker"
      #define BACKEND_HOST  "tu-backend.up.railway.app"   // sin https://
*/

// ============================================================================
//  IDENTIDAD DE LA CAJA  (NO se edita: se carga desde el portal WiFi)
// ============================================================================
// Antes el ID de la caja era una constante fija en este archivo y habia una
// carpeta de firmware por maquina. Ahora vive en la NVS del ESP y los topics se
// arman solos, asi que este sketch sirve para cualquier expendedora de fichas.
String CAJA_ID     = "";
String TOPIC_CMD   = "";   // termopago/<caja>/cmd     backend -> equipo
String TOPIC_STATUS= "";   // termopago/<caja>/status  equipo  -> backend (+ LWT)

#define PORTAL_AP         "TermoPago-setup"   // nombre del AP de configuracion

// ---- Parametros del servicio (COMPLETAR cuando los definas) ----
#define PRECIO_ARS        0        // TODO: precio de la ficha (solo informativo en display/log)
#define CICLO_SEGUNDOS    90       // TODO: duracion del ciclo interno de la maquina (SOLO estetico en el display)

// ---- Dispensador: 2 reles (COIN + BOTON) + sensor de fichas ----
// Estos #define PISAN los valores por defecto de dispensador.h y tienen que ir
// ANTES del #include. El modulo reemplaza al rele unico que habia antes.
//
//   COIN   -> rele: COM al pin GND del conector de 3 pines, NO al pin COIN.
//             (el del medio es COIN; el de afuera, 12V. Verificado con tester:
//              9 V en reposo contra GND => pulso a masa, activo bajo)
//   BOTON  -> rele EN PARALELO con el pulsador fisico que ya esta, sobre el
//             conector BOTON / LLAVE / GND / SENSOR. Contacto seco: hace lo
//             mismo que la persona al apretar, sin importar la polaridad.
//   SENSOR -> opto PC817 desde la linea SENSOR de la placa.
#define DISP_PIN_COIN     26       // rele que pulsa la entrada COIN
#define DISP_PIN_BOTON    25       // rele en paralelo con el pulsador
#define DISP_PIN_SENSOR   27       // opto PC817 desde la linea SENSOR

#define DISP_COIN_ACTIVO_BAJO    1 // modulos rele tipicos (los azules): activos en BAJO
#define DISP_BOTON_ACTIVO_BAJO   1
#define DISP_SENSOR_ACTIVO_BAJO  1

// 1 = hay que apretar el boton para que entregue (lo verificado en banco).
// 0 = con el credito cargado la placa entrega sola -> sobra el rele de BOTON.
// PENDIENTE DE ENSAYO: la prueba del boton se hizo con ENTRADA COIN = $100,
// juntando de a $100 hasta los $3000. Con ENTRADA COIN = $0 un solo pulso ya
// vale la ficha entera y puede que entregue sola. Para saberlo: poner ENTRADA
// COIN = $0, puentear COIN a GND UNA vez y NO tocar el boton.
//   cae la ficha sola          -> bajar esto a 0 (y te ahorras un rele)
//   queda el credito en pantalla -> dejarlo en 1
#define DISP_USAR_BOTON   1

// 1 = verifica cada ficha con el sensor. Con el boton de por medio NO es
// opcional: sin esto el ESP pulsa a ciegas contra una maquina que acumula
// credito. Dejar en 0 solo mientras el PC817 todavia no este cableado.
#define DISP_USAR_SENSOR  0

// Pulsos de MONEDERO por ficha = PRECIO FICHA / valor del pulso de monedero.
// Villagas: PRECIO FICHA = $3000 y el monedero vale $100 por pulso, FIJO en el
// firmware de la placa (se barrieron las 15 combinaciones de DIP: no existe
// menu para cambiarlo). 3000 / 100 = 30 pulsos exactos, sin resto.
//
// NO intentar bajarlo con una PROMOCION. Se probo: la promo no dispara al
// llegar al monto, lo que hace es cambiar el PRECIO de la ficha. Con una promo
// de $200 el credito tiene que llegar igual a $3000 y despues cada pulsacion
// del boton descuenta solo $200 => quien mete $3000 en billetes se lleva 15
// fichas. La placa tiene un solo precio y no distingue de que canal vino la
// plata, asi que abaratar la ficha para el ESP32 la abarata para todos.
//
// Los 100 ms / 250 ms de abajo estan probados contra esta placa. Se podrian
// achicar para que la entrega tarde menos de los ~10 s que tarda hoy, pero
// contar mal la plata es mucho peor que esperar: no tocarlos sin repetir la
// prueba de las 10 fichas.
#define DISP_PULSOS_POR_FICHA  30

// Ancho del pulso de monedero y pausa entre pulsos.
// Arranque: 100 / 250 ms (lo unico probado a mano contra esta placa) => los 30
// pulsos tardaban 10,5 s. Bajado a 80 / 120 ms => 6,0 s, con margen sobre el
// rele (cierra en ~10 ms, abre en ~5 ms, asi que no trabaja al limite).
//
// COMO VALIDAR UN CAMBIO ACA: pedir 1 ficha y mirar que el display marque
// EXACTAMENTE $3000 antes de la pulsacion del boton. Si marca menos, se
// perdieron pulsos. Repetirlo 5 veces, no una: el problema no es que falle
// siempre, es que falle una de cada diez. Falla segura: sin $3000 no sale
// ficha, no se pierde ni se regala plata.
//
// Para bajar mas hay que cambiar el rele por un PC817 en la linea COIN: el
// rele no da para 50/50 ms y ademas es la fuente del riesgo de rebote.
// Espera entre el ultimo pulso de monedero y la pulsacion del boton. Tiene dos
// funciones: darle tiempo a la placa a terminar de acreditar, y dejar el
// credito completo visible en el display un instante (util para verificar de un
// vistazo que entraron los 30 pulsos). Si fuera corta, el sintoma seria: el
// display llega al precio, el rele hace clic, y la ficha no sale.
#define DISP_ESPERA_ACREDITA_MS 1000

#define DISP_PULSO_COIN_MS      40
#define DISP_PAUSA_COIN_MS      60

#define DISP_MAX_FICHAS   5        // tope de fichas por pago (anti-vaciado)

// ---- Boton BOOT (reset de credenciales) ----
#define BOOT_PIN          0        // GPIO0 = boton BOOT del devkit
#define PORTAL_PASS       "termopago"   // clave del AP del portal (min 8 chars)

// ---- LCD ----
#define USAR_LCD          1        // LCD 16x2 I2C propio del ESP: "WiFi conectado / Escanea el QR"
#define LCD_COLS          16
#define LCD_ROWS          2

// ---- BSSID lock (redes doble banda / band-steering) ----
#define LOCK_ON           0        // 0 = portatil (cualquier AP del SSID). 1 = fija al BSSID de abajo.
uint8_t BSSID_FIJO[6] = { 0x00,0x00,0x00,0x00,0x00,0x00 }; // completar si LOCK_ON=1 (la MAC no es secreta)

// ---- Tiempos de confiabilidad ----
const uint32_t HEARTBEAT_MS       = 60000UL;     // publish de estado cada 60 s
const uint32_t MQTT_KEEPALIVE_S   = 60;          // keepalive MQTT (LWT dispara a ~1.5x)
const uint32_t MQTT_RETRY_MS      = 5000UL;      // reintento de conexion al broker
const uint32_t SIN_COMM_TIMEOUT   = 90000UL;     // sin conexion MQTT > 90 s -> reinicio
const uint32_t REINICIO_PREVENT   = 21600000UL;  // 6 h en reposo -> reinicio preventivo
const uint32_t LCD_REINIT_MS      = 300000UL;    // reinit LCD cada 5 min
const uint32_t WDT_TIMEOUT_S      = 30;          // watchdog (30s: margen sobre el connect MQTT de 8s; antes 15 empataba con el socket timeout de PubSubClient y disparaba task_wdt en reconexiones lentas)

// El include va DESPUES de los #define de arriba, que son los que lo configuran.
#include "dispensador.h"

// ============================================================================
//  ESTADO GLOBAL
// ============================================================================
WiFiClientSecure  espClient;
PubSubClient      mqtt(espClient);
Preferences       prefs;
Dispensador       dispensador;

// ---- Identidad: leer/guardar el ID de caja en la NVS ----
void aplicarIdentidad(const String& id) {
  CAJA_ID = id;
  CAJA_ID.trim();
  TOPIC_CMD    = "termopago/" + CAJA_ID + "/cmd";
  TOPIC_STATUS = "termopago/" + CAJA_ID + "/status";
}

void cargarIdentidad() {
  aplicarIdentidad(prefs.getString("caja", ""));
  if (CAJA_ID.length())  Serial.printf("[ID] caja guardada: %s\n", CAJA_ID.c_str());
  else                   Serial.println("[ID] sin ID de caja -> se pedira en el portal");
}

void guardarIdentidad(const String& id) {
  String limpio = id;
  limpio.trim();
  if (limpio.length() == 0 || limpio == CAJA_ID) return;
  prefs.putString("caja", limpio);
  prefs.remove("ultpago");          // caja nueva: el dedup del pago anterior no aplica
  aplicarIdentidad(limpio);
  Serial.printf("[ID] caja nueva guardada: %s\n", CAJA_ID.c_str());
}
#if USAR_LCD
hd44780_I2Cexp    lcd;
bool  lcdOk = false;
#endif

uint32_t bootMs         = 0;
uint32_t ultimoHeartbeat= 0;
uint32_t ultimoMqttOk   = 0;      // ultima vez que el broker estuvo conectado
uint32_t ultimoIntentoMqtt = 0;
uint32_t ultimoLcdReinit= 0;
uint32_t pulsosTotales  = 0;

String   ultimoPagoProcesado = "";   // dedup (se persiste en NVS): ultimo pago ENTREGADO
String   pagoEnCurso         = "";   // pago que el dispensador esta entregando ahora

// Cola de pagos: si entra un pago mientras hay un servicio en curso, espera su
// turno y se activa al terminar (asi no se pierden servicios).
#define  MAX_COLA 5
String   colaPagos[MAX_COLA];
int      colaCantidad[MAX_COLA];
int      colaLen = 0;

// display de conteo estetico
bool     mostrandoCiclo = false;
uint32_t cicloInicioMs  = 0;
int      ultimoRestanteMostrado = -1;   // para refrescar el LCD solo al cambiar el segundo
uint32_t graciasHastaMs = 0;            // hasta cuando mostrar "Listo! Gracias" antes de volver a espera
const uint32_t GRACIAS_MS = 5000;       // 5 s el mensaje de gracias tras el servicio
int      cantidadPendiente = 0;         // segundos del conteo que mando el backend en el cmd
int      cicloSegundos = CICLO_SEGUNDOS;// conteo actual (del server si vino, o el default)

// ============================================================================
//  LCD helpers (robustos)
// ============================================================================
#if USAR_LCD
void lcdRecuperarBus() {
  // 9 pulsos de reloj para liberar un esclavo I2C colgado
  pinMode(SCL, OUTPUT);
  for (int i = 0; i < 9; i++) { digitalWrite(SCL, HIGH); delayMicroseconds(5);
                                digitalWrite(SCL, LOW);  delayMicroseconds(5); }
  pinMode(SCL, INPUT);
}

bool lcdInit() {
  Wire.begin();
  Wire.setTimeOut(50);
  lcdRecuperarBus();
  for (int intento = 0; intento < 12; intento++) {   // hasta 12 reintentos de init
    if (lcd.begin(LCD_COLS, LCD_ROWS) == 0) {
      lcd.clear();
      return true;
    }
    delay(120);
    lcdRecuperarBus();
  }
  return false;
}

void lcdLinea(uint8_t fila, const String& txt) {
  if (!lcdOk) return;
  lcd.setCursor(0, fila);
  String s = txt;
  while (s.length() < LCD_COLS) s += ' ';
  if (s.length() > LCD_COLS) s = s.substring(0, LCD_COLS);
  lcd.print(s);
}
#else
bool lcdInit() { return true; }
void lcdLinea(uint8_t, const String&) {}
#endif

void mostrar(const String& l1, const String& l2) {
  lcdLinea(0, l1);
  lcdLinea(1, l2);
  Serial.printf("[LCD] %s | %s\n", l1.c_str(), l2.c_str());
}

// Pantalla de reposo: lo que ve el cliente cuando el equipo esta listo para
// cobrar. El texto coincide con el cartel ("la pantalla debe decir WiFi conectado").
void pantallaEspera() {
  mostrar("WiFi conectado", "Escanea el QR");
}

// ============================================================================
//  WATCHDOG (esp_task_wdt con trigger_panic = true)
//  Guarda por version del core (API distinta en 2.x vs 3.x)
// ============================================================================
bool wdtTaskAdded = false;   // true cuando el loop ya esta suscripto al watchdog
void watchdogInit() {
#if __has_include("esp_task_wdt.h")
  #if ESP_ARDUINO_VERSION_MAJOR >= 3
    // Core 3.x: config por struct
    esp_task_wdt_config_t cfg = {
      .timeout_ms   = WDT_TIMEOUT_S * 1000,
      .idle_core_mask = 0,
      .trigger_panic = true
    };
    // si ya estaba inicializado por el core, reconfiguramos
    if (esp_task_wdt_reconfigure(&cfg) != ESP_OK) {
      esp_task_wdt_init(&cfg);
    }
    // OJO: NO suscribimos el loop task todavia. El portal de WiFiManager puede
    // tardar minutos y bloquea el loop -> el WDT lo reiniciaria. Se suscribe
    // recien despues de conectar el WiFi, con watchdogAddTask().
  #else
    // Core 2.x: firma (timeout_s, panic)
    esp_task_wdt_init(WDT_TIMEOUT_S, true);   // true = trigger_panic -> reinicia
  #endif
  Serial.println("[WDT] watchdog iniciado (se activa la vigilancia tras el WiFi)");
#endif
}
// Suscribe el loop task al watchdog. Llamar SOLO despues de conectar el WiFi,
// para que el portal de configuracion pueda tardar sin provocar un reinicio.
void watchdogAddTask() {
#if __has_include("esp_task_wdt.h")
  esp_task_wdt_add(NULL);
  wdtTaskAdded = true;
  Serial.println("[WDT] loop vigilado por el watchdog");
#endif
}
void watchdogFeed() {
#if __has_include("esp_task_wdt.h")
  if (wdtTaskAdded) esp_task_wdt_reset();   // solo alimenta si el loop ya esta suscripto
#endif
}

// ============================================================================
//  MOTIVO DE REINICIO
// ============================================================================
String motivoReinicio() {
  switch (esp_reset_reason()) {
    case ESP_RST_POWERON:  return "poweron";
    case ESP_RST_SW:       return "sw_restart";
    case ESP_RST_PANIC:    return "panic";
    case ESP_RST_INT_WDT:  return "int_wdt";
    case ESP_RST_TASK_WDT: return "task_wdt";
    case ESP_RST_WDT:      return "wdt";
    case ESP_RST_BROWNOUT: return "brownout";
    case ESP_RST_DEEPSLEEP:return "deepsleep";
    default:               return "otro";
  }
}

// reporte al backend por HTTPS (5 reintentos) -> /boot/<id>/<motivo>
void reportarBoot() {
  String motivo = motivoReinicio();
  String url = String("https://") + BACKEND_HOST + "/boot/" + CAJA_ID + "/" + motivo;
  for (int i = 0; i < 5; i++) {
    watchdogFeed();
    if (WiFi.status() != WL_CONNECTED) { delay(1000); continue; }
    WiFiClientSecure c;
    c.setInsecure();                 // reporte de boot: sin pin de CA (no es critico)
    HTTPClient http;
    http.setTimeout(8000);
    if (http.begin(c, url)) {
      int code = http.GET();
      http.end();
      Serial.printf("[BOOT] reporte '%s' intento %d -> %d\n", motivo.c_str(), i+1, code);
      if (code > 0) return;
    }
    delay(1500);
  }
  Serial.println("[BOOT] no se pudo reportar el boot (sigo igual)");
}

// ============================================================================
//  WIFI
// ============================================================================
void ventanaResetCredenciales() {
  // 5 s post-boot: si mantenés BOOT apretado, borra SOLO el WiFi.
  //
  // El ID de caja NO se borra a proposito. Este boton lo aprieta el cliente
  // cuando le cambian la red, y si tuviera que re-escribir el ID un error de
  // tipeo ("villagas1", "Villagas01") deja la maquina encendida, con IP y con
  // cara de sana, pero sin cobrar un solo pago: los topics MQTT se arman con
  // ese texto y nadie le avisa a nadie. El ID sigue siendo editable desde el
  // portal -el campo aparece con el valor actual cargado-, asi que para
  // reinstalar una caja en otro lado se cambia ahi.
  pinMode(BOOT_PIN, INPUT_PULLUP);
  mostrar("TermoPago", "BOOT=reset 5s");
  uint32_t t0 = millis();
  while (millis() - t0 < 5000) {
    watchdogFeed();
    if (digitalRead(BOOT_PIN) == LOW) {
      mostrar("Borrando WiFi", "reiniciando");
      WiFiManager wm; wm.resetSettings(); borrarLock();
      delay(800);
      ESP.restart();
    }
    delay(20);
  }
}

// Portal (WiFiManager) para tomar el WiFi del cliente + auto-lock de la radio:
// la 1ra vez que conecta aprende BSSID+canal y lo guarda; despues reconecta
// clavado a esa radio, para que un router doble banda no lo salte de banda.
Preferences wifiPrefs;
static uint8_t lockedBssid[6];
static int32_t lockedChannel = 0;
static bool    haveLock      = false;

void cargarLock() {
  wifiPrefs.begin("wifiloc", true);
  size_t n = wifiPrefs.getBytes("bssid", lockedBssid, 6);
  lockedChannel = wifiPrefs.getInt("chan", 0);
  wifiPrefs.end();
  haveLock = (n == 6 && lockedChannel > 0);
}

void guardarLock() {
  uint8_t* b  = WiFi.BSSID();
  int32_t  ch = WiFi.channel();
  if (b == nullptr || ch <= 0) return;
  wifiPrefs.begin("wifiloc", false);
  wifiPrefs.putBytes("bssid", b, 6);
  wifiPrefs.putInt("chan", ch);
  wifiPrefs.end();
  memcpy(lockedBssid, b, 6);
  lockedChannel = ch;
  haveLock = true;
  Serial.printf("[WiFi] radio guardada: canal %d, BSSID %02X:%02X:%02X:%02X:%02X:%02X\n",
                (int)ch, b[0], b[1], b[2], b[3], b[4], b[5]);
}

void borrarLock() {
  wifiPrefs.begin("wifiloc", false);
  wifiPrefs.clear();
  wifiPrefs.end();
  haveLock = false;
  memset(lockedBssid, 0, 6);
  lockedChannel = 0;
}

void conectarWiFi() {
  WiFi.mode(WIFI_STA);
  WiFi.setSleep(false);
  WiFi.setAutoReconnect(true);
  WiFi.persistent(true);

  WiFiManager wm;
  // Campo extra del portal: el ID que le toca a este equipo (lo da /admin).
  WiFiManagerParameter campoCaja("caja", "ID de caja (ej: villagas01)",
                                 CAJA_ID.c_str(), 40);
  wm.addParameter(&campoCaja);

  String red  = wm.getWiFiSSID();
  String pass = wm.getWiFiPass();
  mostrar("Conectando WiFi", "Por favor espere");

  // Sin ID de caja no hay nada que hacer: hay que pasar por el portal aunque
  // el WiFi ya este guardado.
  if (red.length() > 0 && CAJA_ID.length() > 0) {
    cargarLock();
    unsigned long t0 = millis();
    if (haveLock) {
      WiFi.begin(red.c_str(), pass.c_str(), lockedChannel, lockedBssid);
      while (WiFi.status() != WL_CONNECTED && millis() - t0 < 18000) delay(250);
      if (WiFi.status() != WL_CONNECTED) {
        Serial.println("[WiFi] radio guardada no responde -> reintento libre");
        WiFi.begin(red.c_str(), pass.c_str());
        t0 = millis();
        while (WiFi.status() != WL_CONNECTED && millis() - t0 < 15000) delay(250);
        if (WiFi.status() == WL_CONNECTED) guardarLock();
      }
    } else {
      WiFi.begin(red.c_str(), pass.c_str());
      while (WiFi.status() != WL_CONNECTED && millis() - t0 < 25000) delay(250);
      if (WiFi.status() == WL_CONNECTED) guardarLock();
    }
    if (WiFi.status() != WL_CONNECTED) { mostrar("Sin WiFi", "reiniciando"); delay(1500); ESP.restart(); }
  } else {
    wm.setConfigPortalTimeout(180);
    bool ok;
    if (CAJA_ID.length() == 0) {
      // autoConnect saltearia el portal si el WiFi ya estuviera guardado, y
      // necesitamos preguntar el ID si o si -> portal explicito.
      mostrar("Falta ID de caja", PORTAL_AP);
      ok = wm.startConfigPortal(PORTAL_AP, PORTAL_PASS);
    } else {
      ok = wm.autoConnect(PORTAL_AP, PORTAL_PASS);
    }
    if (!ok) { mostrar("Sin config", "reiniciando"); delay(1500); ESP.restart(); }
    guardarLock();
    guardarIdentidad(campoCaja.getValue());
  }

  Serial.printf("[WiFi] conectado a %s  IP %s  RSSI %d\n",
                WiFi.SSID().c_str(), WiFi.localIP().toString().c_str(), WiFi.RSSI());
  mostrar("WiFi " + CAJA_ID, WiFi.localIP().toString());
}

// reconexion sin flapping: mensaje + delay + reintento (NO reabre portal)
void asegurarWiFi() {
  if (WiFi.status() == WL_CONNECTED) return;
  Serial.println("[WiFi] perdido, reintentando...");
  mostrar("WiFi caido", "reconectando...");
  uint32_t t0 = millis();
  while (WiFi.status() != WL_CONNECTED) {
    watchdogFeed();
    WiFi.reconnect();
    delay(3000);
    // si estuvo mucho sin WiFi, el timeout de "sin comunicacion" lo reiniciara
    if (millis() - t0 > SIN_COMM_TIMEOUT) {
      Serial.println("[WiFi] demasiado tiempo sin red -> reinicio");
      ESP.restart();
    }
  }
  mostrar("WiFi " + CAJA_ID, WiFi.localIP().toString());
}

// ============================================================================
//  MQTT
// ============================================================================
String heartbeatJson(const char* estado) {
  StaticJsonDocument<384> doc;
  doc["caja"]        = CAJA_ID;
  doc["estado"]      = estado;              // "online" / "offline"
  doc["uptime_s"]    = (millis() - bootMs) / 1000;
  doc["rssi"]        = WiFi.RSSI();
  doc["heap"]        = ESP.getFreeHeap();
  doc["pulsos"]      = pulsosTotales;
  doc["ultimo_pago"] = ultimoPagoProcesado;
  // Dispensador: lo que el backend necesita para detectar una maquina que cobra
  // y no entrega. credito_varado > 0 = hay plata cargada sin ficha entregada.
  doc["dispensador"]    = dispensador.estadoTxt();
  doc["credito_varado"] = dispensador.creditoVarado();
  doc["fichas_sensor"]  = dispensador.fichasVistas();
  doc["pulsos_ficha"]   = dispensador.pulsosPorFicha();
  String out; serializeJson(doc, out);
  return out;
}

void publicarEstado(const char* estado, bool retained) {
  if (!mqtt.connected()) return;
  String p = heartbeatJson(estado);
  mqtt.publish(TOPIC_STATUS.c_str(), p.c_str(), retained);
  Serial.printf("[MQTT] status -> %s\n", p.c_str());
}

// encola un pago para activarlo cuando el equipo este libre (con dedup)
void encolarPago(const String& pagoId, int seg) {
  if (pagoId == ultimoPagoProcesado) {                 // ya se sirvio / esta corriendo
    Serial.printf("[COLA] %s ya procesado, ignoro\n", pagoId.c_str());
    return;
  }
  for (int i = 0; i < colaLen; i++)                    // ya esta esperando en la cola
    if (colaPagos[i] == pagoId) {
      Serial.printf("[COLA] %s ya en cola, ignoro\n", pagoId.c_str());
      return;
    }
  if (colaLen >= MAX_COLA) { Serial.println("[COLA] llena, descarto"); return; }
  colaPagos[colaLen]    = pagoId;
  colaCantidad[colaLen] = seg;
  colaLen++;
  Serial.printf("[COLA] encolado %s (%d fichas). En cola: %d\n", pagoId.c_str(), seg, colaLen);
}

// callback: llega orden de activar
void mqttCallback(char* topic, byte* payload, unsigned int len) {
  String msg; msg.reserve(len);
  for (unsigned int i = 0; i < len; i++) msg += (char)payload[i];
  Serial.printf("[MQTT] %s : %s\n", topic, msg.c_str());

  StaticJsonDocument<256> doc;
  if (deserializeJson(doc, msg)) { Serial.println("[MQTT] JSON invalido"); return; }

  const char* accion = doc["accion"] | "";
  String pagoId = String((const char*)(doc["pago_id"] | ""));
  if (strcmp(accion, "activar") != 0 || pagoId.length() == 0) return;

  // cantidad de fichas a entregar (editable desde /config del backend). Default 1.
  int cant = (int)(doc["cantidad"] | 1);

  // pulsos de monedero por ficha: lo calcula el backend como
  // PRECIO FICHA de la placa / valor del pulso. Permite cambiar el precio en la
  // placa sin reflashear. Si no viene, se queda con el compilado.
  int pulsos = (int)(doc["pulsos"] | 0);
  if (pulsos > 0 && pulsos != dispensador.pulsosPorFicha()) {
    dispensador.pulsosPorFicha(pulsos);
    Serial.printf("[FICHAS] pulsos por ficha -> %d (del backend)\n",
                  dispensador.pulsosPorFicha());
  }

  // a la cola: si esta entregando, espera su turno; el loop lo activa al quedar libre
  encolarPago(pagoId, cant);
}

boolean mqttConectar() {
  String clientId = String("termopago-") + CAJA_ID;   // estable -> sesion persistente
  String willMsg  = heartbeatJson("offline");
  // connect(id, user, pass, willTopic, willQos, willRetain, willMsg, cleanSession=false)
  bool ok = mqtt.connect(clientId.c_str(), MQTT_USER, MQTT_PASS,
                         TOPIC_STATUS.c_str(), 1, false, willMsg.c_str(), false);
  if (ok) {
    Serial.println("[MQTT] conectado al broker");
    mqtt.subscribe(TOPIC_CMD.c_str(), 1);          // QoS 1
    publicarEstado("online", false);       // NO retenido: el backend se entera por el heartbeat en vivo
    ultimoMqttOk = millis();
    if (!mostrandoCiclo) pantallaEspera();   // pantalla de reposo para el cliente
  } else {
    Serial.printf("[MQTT] fallo conexion, rc=%d\n", mqtt.state());
  }
  return ok;
}

void asegurarMqtt() {
  if (mqtt.connected()) { ultimoMqttOk = millis(); return; }
  if (millis() - ultimoIntentoMqtt < MQTT_RETRY_MS) return;
  ultimoIntentoMqtt = millis();
  mostrar("Reconectando", "broker MQTT...");
  mqttConectar();
}

// ============================================================================
//  ENTREGA DE FICHAS  (via dispensador.h: rele COIN + rele BOTON + sensor)
// ============================================================================
// Ya no hay tren de pulsos bloqueante. El modulo hace, por cada ficha:
//     pulso COIN -> pausa -> espera que acredite -> pulso BOTON -> espera sensor
// sin bloquear el loop (asi el MQTT y el watchdog siguen corriendo durante toda
// la entrega). De a UNA ficha por vez a proposito: si falla en la ficha 3 de 5
// queda varado el credito de una sola, no el de cinco.

// Arranca la entrega. No bloquea: termina en entregaTerminada().
void entregarFichas(const String& pagoId, int cantidad) {
  // DEDUP: si ya entregamos este pago, no repetimos (evita doble entrega)
  if (pagoId == ultimoPagoProcesado) {
    Serial.printf("[FICHAS] pago %s ya procesado, ignoro\n", pagoId.c_str());
    return;
  }
  if (!dispensador.pedir(cantidad)) {
    // Ocupado: el pago sigue en la cola y el loop lo reintenta al quedar libre.
    Serial.println("[FICHAS] dispensador ocupado, queda en cola");
    return;
  }
  pagoEnCurso = pagoId;
  Serial.printf("[FICHAS] entregando %d ficha(s) por pago %s\n", cantidad, pagoId.c_str());
}

// Callback del modulo: aca se cierra el pago. Se llama una sola vez por lote,
// con o sin error.
void entregaTerminada(int pedidas, int entregadas, DispError err) {
  // El dedup se marca recien aca: si el equipo se corta en el medio, el pago
  // NO queda como servido y se puede reintentar.
  ultimoPagoProcesado = pagoEnCurso;
  prefs.putString("ultpago", ultimoPagoProcesado);

  pulsosTotales += entregadas;
  prefs.putUInt("pulsos", pulsosTotales);

  graciasHastaMs = millis() + GRACIAS_MS;   // el modulo ya puso el texto en el LCD
  publicarEstado("online", false);          // el heartbeat lleva el detalle de la falla

  if (err == DISP_OK) {
    Serial.printf("[FICHAS] entrega completa: %d ficha(s).\n", entregadas);
  } else {
    // Hopper vacio o atascado. Si quedo credito cargado, alguien puede llevarse
    // una ficha gratis apretando el boton fisico: va al backend por el heartbeat.
    Serial.printf("[FICHAS] FALLA: pedidas %d, entregadas %d (%s). Credito varado: %u\n",
                  pedidas, entregadas, Dispensador::errorTxt(err),
                  (unsigned)dispensador.creditoVarado());
    // TODO backend: POST /entrega_fallida/<caja>/<pago> con pedidas vs entregadas
    // para que reembolse la diferencia.
  }
  pagoEnCurso = "";
}

// conteo estetico del ciclo (el ESP NO controla la maquina, solo lo muestra)
void actualizarDisplayCiclo() {
  if (!mostrandoCiclo) return;
  uint32_t transcurrido = (millis() - cicloInicioMs) / 1000;
  if (transcurrido >= (uint32_t)cicloSegundos) {
    mostrandoCiclo = false;
    ultimoRestanteMostrado = -1;
    mostrar("Listo!", "Gracias!");
    graciasHastaMs = millis() + GRACIAS_MS;   // luego vuelve a "Escanea el QR"
    return;
  }
  int restante = cicloSegundos - (int)transcurrido;
  if (restante == ultimoRestanteMostrado) return;   // solo refresca cuando cambia el segundo
  ultimoRestanteMostrado = restante;
  char l2[17];
  snprintf(l2, sizeof(l2), "quedan %3d s", restante);
  mostrar("Inflando...", String(l2));
}

// ============================================================================
//  SETUP
// ============================================================================
// -- Hora por NTP: necesaria para validar el certificado TLS del broker.
// Si no la conseguimos, el que llama cae a setInsecure() para NO dejar el
// equipo sin conectar por un problema de reloj. Alimenta el watchdog mientras
// espera. Devuelve true si consiguio hora real (epoch > nov-2023).
bool sincronizarHora() {
  configTime(0, 0, "pool.ntp.org", "time.nist.gov");
  unsigned long t0 = millis();
  while (time(nullptr) < 1700000000UL && millis() - t0 < 10000) {
    delay(200);
    watchdogFeed();
  }
  return time(nullptr) > 1700000000UL;
}

void setup() {
  Serial.begin(115200);
  delay(200);
  bootMs = millis();

  // Dispensador: deja los dos reles abiertos ANTES de ponerlos como salida,
  // para no tirar un pulso espurio (= una ficha regalada) en el arranque.
  dispensador.begin();
  dispensador.alMostrar([](const char* a, const char* b){ mostrar(a, b); });
  dispensador.alTerminar(entregaTerminada);

  watchdogInit();

#if USAR_LCD
  lcdOk = lcdInit();
#endif
  // NVS: primero la identidad (de que caja somos), despues el dedup.
  prefs.begin("termopago", false);
  cargarIdentidad();
  mostrar("TermoPago", CAJA_ID.length() ? CAJA_ID : String("sin ID"));
  ultimoPagoProcesado = prefs.getString("ultpago", "");
  pulsosTotales       = prefs.getUInt("pulsos", 0);

  ventanaResetCredenciales();     // 5 s con BOOT para borrar WiFi
  conectarWiFi();                 // aca puede abrirse el portal y tardar lo que haga falta

  watchdogAddTask();              // recien ahora el watchdog vigila el loop (WiFi ya conectado)

  reportarBoot();                 // registra el motivo del ultimo reinicio

  // MQTT sobre TLS
  // TLS del broker: si tenemos hora, validamos el certificado (setCACert con
  // las raices ISRG X1/X2). Si NO hay hora (NTP caido), caemos a setInsecure()
  // para que el equipo se conecte igual -> el endurecimiento nunca lo aisla.
  if (sincronizarHora()) {
    espClient.setCACert(HIVEMQ_CA_BUNDLE);
    Serial.println("[TLS] hora OK -> valido el certificado del broker");
  } else {
    espClient.setInsecure();
    Serial.println("[TLS] sin hora NTP -> setInsecure (degradado, pero conecta)");
  }
  mqtt.setServer(MQTT_HOST, MQTT_PORT);
  mqtt.setKeepAlive(MQTT_KEEPALIVE_S);
  mqtt.setSocketTimeout(8);       // connect()/socket NO pueden colgarse mas de 8s (default PubSubClient = 15s, que empataba con el watchdog y disparaba task_wdt en reconexiones lentas al broker)
  mqtt.setBufferSize(512);        // JSON + TLS: subir el buffer (default 256 es justo)
  mqtt.setCallback(mqttCallback);
  mqttConectar();

  ultimoMqttOk    = millis();
  ultimoHeartbeat = millis();
  ultimoLcdReinit = millis();
}

// ============================================================================
//  LOOP
// ============================================================================
void loop() {
  watchdogFeed();

  asegurarWiFi();
  asegurarMqtt();
  mqtt.loop();

  // ---- maquina de estados de la entrega (no bloquea) ----
  dispensador.actualizar();

  // ---- activar el proximo pago de la cola cuando el equipo esta libre ----
  if (!dispensador.ocupado() && !mostrandoCiclo && graciasHastaMs == 0 && colaLen > 0) {
    String p          = colaPagos[0];
    cantidadPendiente = colaCantidad[0];
    for (int i = 1; i < colaLen; i++) {   // desplazar la cola (FIFO)
      colaPagos[i-1]    = colaPagos[i];
      colaCantidad[i-1] = colaCantidad[i];
    }
    colaLen--;
    entregarFichas(p, cantidadPendiente);
  }

  // ---- heartbeat cada 60 s ----
  if (millis() - ultimoHeartbeat >= HEARTBEAT_MS) {
    ultimoHeartbeat = millis();
    publicarEstado("online", false);
    // reasegurar la pantalla de reposo si estamos ociosos (recupera la pantalla
    // tras mensajes transitorios como "reconectando")
    // ojo: NO pisar el "Entregando..." mientras el dispensador trabaja
    if (!dispensador.ocupado() && !mostrandoCiclo && graciasHastaMs == 0 && mqtt.connected())
      pantallaEspera();
  }

  // ---- conteo estetico del ciclo ----
  if (mostrandoCiclo) actualizarDisplayCiclo();

  // ---- volver a la pantalla de espera tras el mensaje de "gracias" ----
  if (!mostrandoCiclo && graciasHastaMs && millis() >= graciasHastaMs) {
    graciasHastaMs = 0;
    pantallaEspera();
  }

  // ---- reinicio por "sin comunicacion" (MQTT caido > 90 s) ----
  // NO reinicia durante una entrega: reiniciar con el credito ya cargado y la
  // ficha sin salir es justo como queda credito varado en la maquina.
  if (!dispensador.ocupado() && !mostrandoCiclo && (millis() - ultimoMqttOk > SIN_COMM_TIMEOUT)) {
    Serial.println("[SIN COMM] broker inalcanzable > 90 s -> reinicio");
    mostrar("Sin broker", "reiniciando");
    delay(500);
    ESP.restart();
  }

  // ---- reinicio preventivo cada 6 h en reposo ----
  if (!dispensador.ocupado() && !mostrandoCiclo && (millis() - bootMs > REINICIO_PREVENT)) {
    Serial.println("[PREVENTIVO] 6 h en reposo -> reinicio limpio");
    delay(200);
    ESP.restart();
  }

#if USAR_LCD
  // ---- reinit periodico del LCD ----
  if (millis() - ultimoLcdReinit > LCD_REINIT_MS) {
    ultimoLcdReinit = millis();
    if (!lcd.status()) lcdOk = lcdInit();
  }
#endif

  // ---- chequeo de heap ----
  // El umbral blando (20k) espera a que termine el servicio; solo un OOM critico
  // (<10k) reinicia igual en pleno conteo para no colgarse.
  uint32_t heapLibre = ESP.getFreeHeap();
  if ((heapLibre < 20000 && !dispensador.ocupado() && !mostrandoCiclo) || heapLibre < 10000) {
    Serial.printf("[HEAP] bajo: %u -> reinicio preventivo\n", heapLibre);
    delay(200);
    ESP.restart();
  }

  delay(10);
}

/*  ============================================================================
    NOTA TLS: YA IMPLEMENTADO (ver setup()).
    El TLS del broker esta endurecido: se sincroniza la hora por NTP y se valida
    el certificado con las raices de Let's Encrypt (ca_hivemq.h: ISRG X1 + X2)
    via espClient.setCACert(HIVEMQ_CA_BUNDLE). Si el NTP falla, cae a
    setInsecure() para no dejar el equipo sin conectar (endurecimiento best-effort).
    El reporte de boot al backend (Railway) sigue en setInsecure() a proposito:
    apunta a otra CA distinta y no es un canal critico.
    ============================================================================ */
