marcospiana/termopago/firmware/estacion01_maestro_mqtt/estacion01_maestro_mqtt.ino

// TermoPago - ESTACION 01 - MAESTRO (ESP32)  [MQTT push, SIN polling]
// =====================================================================
// Version MQTT del maestro. Reemplaza el polling HTTPS cada 4s (que
// fragmentaba la RAM y colgaba el ESP) por una conexion MQTT persistente.
//
// Maneja DOS canales: aspiradora01 (canal 0) y soplado01 (canal 1).
// Cuando entra un pago, el backend publica al topic del canal y este ESP
// le ordena al ESCLAVO (Arduino Nano) activar el canal por X segundos.
// El ESCLAVO maneja el RELE, el TIEMPO y el CONTADOR -> el servicio sigue
// aunque el maestro pierda WiFi o se reinicie. El maestro NO tiene reles ni LCD.
//
// HTTP puntual (NO fragmenta: el problema era el handshake CADA 4s):
//   - al volver de un corte del broker: GET /orden/<id> por canal, para cobrar
//     los pagos que entraron mientras no habia MQTT (camino independiente).
//   - al bootear: GET /orden/<id> por canal, para retomar un servicio que
//     quedo a mitad por un corte de luz (el /orden devuelve el restante).
//   - al terminar un servicio: GET /completar/<id>.
//   - al arrancar: GET /boot/<id>/<motivo>.
//
// CONEXIONES (igual que el maestro viejo):
//   Enlace al esclavo Nano:  GPIO17 (TX2) -> Nano D3 (RX)   + GND comun
//   BOOT (GPIO0): ventana de 5s al encender para resetear el WiFi
//
// SECRETOS: copiar secretos_privado.h (el mismo de inflado) a esta carpeta.
//   Define MQTT_HOST/PORT/USER/PASS y BACKEND_HOST.
// =====================================================================

#include <WiFi.h>
#include <WiFiClientSecure.h>
#include <WiFiManager.h>
#include <PubSubClient.h>
#include <ArduinoJson.h>
#include <HTTPClient.h>
#include <esp_task_wdt.h>
#include <esp_system.h>
#include "secretos_privado.h"   // MQTT_HOST/PORT/USER/PASS, BACKEND_HOST
#include <time.h>              // configTime/time() para validar el cert TLS
#include "ca_hivemq.h"        // raices CA de Lets Encrypt (ISRG X1/X2)
#include <Preferences.h>      // guardar la radio WiFi aprendida (BSSID/canal)

// ── Canales de esta estacion ──────────────────────────────────────
const int   NUM_CANALES = 2;
const char* IDS[NUM_CANALES]  = {"aspiradora01", "soplado01"};
const char* ETIQ[NUM_CANALES] = {"Aspirad", "Soplado"};

// topics MQTT por canal
String TOPIC_CMD(int i)    { return String("termopago/") + IDS[i] + "/cmd"; }
String TOPIC_STATUS(int i) { return String("termopago/") + IDS[i] + "/status"; }

// ── Enlace UART al esclavo (un solo sentido) ──────────────────────
#define LINK_RX 16   // sin uso
#define LINK_TX 17   // -> RX del Nano (D3)

// ── BSSID lock opcional (band-steering 2.4/5GHz) ──────────────────
#define LOCK_ON 0
uint8_t LOCK_BSSID[6] = {0x00,0x00,0x00,0x00,0x00,0x00};
int32_t LOCK_CHANNEL  = 1;

// Clave del AP del portal de configuracion (minimo 8 caracteres). Cambiala si querés.
#define PORTAL_PASS "termopago"

// ── Tiempos ───────────────────────────────────────────────────────
const int      WDT_TIMEOUT_S    = 30;
const uint32_t HEARTBEAT_MS     = 60000UL;
const uint32_t MQTT_KEEPALIVE_S = 60;
const uint32_t MQTT_RETRY_MS    = 5000UL;
const uint32_t SIN_COMM_TIMEOUT = 90000UL;    // sin MQTT > 90s (en reposo) -> reinicio
// Si estuvimos mas de esto sin broker, al volver preguntamos por HTTP si quedo
// algun pago sin entregar: mientras no habia MQTT, el backend no pudo avisarnos.
const uint32_t RECUPERAR_TRAS_MS = 30000UL;
const uint32_t REINICIO_PREVENT = 21600000UL; // 6h en reposo -> reinicio limpio

// ── Estado ────────────────────────────────────────────────────────
WiFiClientSecure espClient;
PubSubClient     mqtt(espClient);

// Reconexion al broker: cuando se cayo y si hay que ir a buscar pagos perdidos.
uint32_t mqttCaidoDesde  = 0;      // 0 = no estamos caidos
bool     pedirPendientes = false;  // lo atiende el loop (el GET bloquea)

bool          activo[NUM_CANALES]  = {false, false};
unsigned long finMs[NUM_CANALES]   = {0, 0};
String        ordenId[NUM_CANALES] = {"", ""};
String        pendienteCompletar[NUM_CANALES] = {"", ""};

// cola por canal: si entra un pago mientras el canal esta ocupado, espera turno
#define MAX_COLA 3
String        colaOrden[NUM_CANALES][MAX_COLA];
int           colaSeg[NUM_CANALES][MAX_COLA];
int           colaLen[NUM_CANALES] = {0, 0};

uint32_t bootMs = 0, ultimoHeartbeat = 0, ultimoMqttOk = 0, ultimoIntentoMqtt = 0, ultimoLcdMs = 0;
bool     wdtAdded = false;

// ─── Enlace al esclavo por UART (protocolo intacto) ───────────────
void mostrar(String l1, String l2) {
  while (l1.length() < 16) l1 += " ";  l1 = l1.substring(0, 16);
  while (l2.length() < 16) l2 += " ";  l2 = l2.substring(0, 16);
  Serial2.print('1'); Serial2.print(l1); Serial2.print('\n');
  Serial2.print('2'); Serial2.print(l2); Serial2.print('\n');
}
void enviarActivar(int canal, int segundos, String orden) {
  Serial2.print("A,"); Serial2.print(canal); Serial2.print(",");
  Serial2.print(segundos); Serial2.print(","); Serial2.print(orden);
  Serial2.print('\n');
  Serial.printf("-> esclavo: A,%d,%d,%s\n", canal, segundos, orden.c_str());
}

// ─── Watchdog (esp_task_wdt con trigger_panic) ────────────────────
void watchdogInit() {
#if defined(ESP_ARDUINO_VERSION_MAJOR) && ESP_ARDUINO_VERSION_MAJOR >= 3
  esp_task_wdt_config_t cfg = { .timeout_ms = (uint32_t)WDT_TIMEOUT_S*1000, .idle_core_mask = 0, .trigger_panic = true };
  if (esp_task_wdt_reconfigure(&cfg) != ESP_OK) esp_task_wdt_init(&cfg);
#else
  esp_task_wdt_init(WDT_TIMEOUT_S, true);
#endif
  // el loop se suscribe recien tras conectar el WiFi (el portal puede tardar)
}
void watchdogAddTask() { esp_task_wdt_add(NULL); wdtAdded = true; }
void watchdogFeed()    { if (wdtAdded) esp_task_wdt_reset(); }

// ─── Causa del reinicio ───────────────────────────────────────────
String motivoReinicio() {
  switch (esp_reset_reason()) {
    case ESP_RST_POWERON:   return "corte-luz";
    case ESP_RST_SW:        return "software";
    case ESP_RST_PANIC:     return "panic-crash";
    case ESP_RST_INT_WDT:   return "wdt-interrupt";
    case ESP_RST_TASK_WDT:  return "wdt-task";
    case ESP_RST_WDT:       return "wdt-otro";
    case ESP_RST_BROWNOUT:  return "brownout-elec";
    default:                return "desconocido";
  }
}

// ─── HTTP puntual: boot / completar / resume ──────────────────────
bool httpGet(const String& url, String* body = nullptr) {
  if (WiFi.status() != WL_CONNECTED) return false;
  WiFiClientSecure c; c.setInsecure();
  HTTPClient http; http.setConnectTimeout(5000); http.setTimeout(6000);
  if (!http.begin(c, url)) return false;
  int code = http.GET();
  if (body && code == 200) *body = http.getString();
  http.end();
  return code == 200;
}

void reportarBoot() {
  String motivo = motivoReinicio();
  for (int i = 0; i < 5; i++) {
    watchdogFeed();
    if (httpGet(String("https://") + BACKEND_HOST + "/boot/" + IDS[0] + "/" + motivo)) {
      Serial.println("[BOOT] reportado: " + motivo); return;
    }
    delay(1500);
  }
}

void completarOrden(const String& id) {
  if (id == "") return;
  for (int i = 0; i < 3; i++) {
    watchdogFeed();
    if (httpGet(String("https://") + BACKEND_HOST + "/completar/" + id)) {
      Serial.println("[COMPLETAR] ok: " + id); return;
    }
    delay(1500);
  }
  Serial.println("[COMPLETAR] fallo (el backend la expira solo): " + id);
}

// Al bootear: retomar un servicio que quedo a mitad (corte de luz).
// Reusa /orden, que devuelve el restante de una orden 'ejecutando'. El esclavo
// deduplica por orden: si el canal sigue corriendo, ignora; si hubo corte de
// luz total, lo retoma con el restante.
void resumeCanal(int i) {
  String body;
  if (!httpGet(String("https://") + BACKEND_HOST + "/orden/" + IDS[i], &body)) return;
  StaticJsonDocument<300> doc;
  if (deserializeJson(doc, body)) return;
  if (doc["encender"] == true) {
    int seg = doc["segundos"] | 0;
    String orden = String((const char*)(doc["orden_id"] | ""));
    if (seg > 5) {
      activo[i] = true;
      finMs[i] = millis() + (unsigned long)seg * 1000UL;
      ordenId[i] = orden;
      enviarActivar(i, seg, orden);
      Serial.printf("[RESUME] %s retomado %ds\n", IDS[i], seg);
    }
  }
}

// ─── Activar un canal (o encolar si esta ocupado) ─────────────────
void activarCanal(int canal, int seg, const String& orden) {
  if (canal < 0 || canal >= NUM_CANALES) return;
  // dedup: mismo pago en curso o ya en cola
  if (orden == ordenId[canal] && activo[canal]) return;
  for (int k = 0; k < colaLen[canal]; k++) if (colaOrden[canal][k] == orden) return;

  if (activo[canal]) {                     // ocupado: a la cola
    if (colaLen[canal] < MAX_COLA) {
      colaOrden[canal][colaLen[canal]] = orden;
      colaSeg[canal][colaLen[canal]]   = seg;
      colaLen[canal]++;
      Serial.printf("[COLA] %s encolado en canal %d. En cola: %d\n", orden.c_str(), canal, colaLen[canal]);
    } else {
      // Descarte. Por MQTT la orden sigue 'pendiente' y el backend la
      // reembolsa; aun asi tiene que quedar registrado, porque mudo es
      // indistinguible de que el pago nunca haya llegado.
      Serial.printf("[COLA] canal %d LLENO (%d): se descarta %s\n",
                    canal, MAX_COLA, orden.c_str());
    }
    return;
  }
  // libre: activar ya
  activo[canal]   = true;
  finMs[canal]    = millis() + (unsigned long)seg * 1000UL;
  ordenId[canal]  = orden;
  enviarActivar(canal, seg, orden);
}

// ─── MQTT ─────────────────────────────────────────────────────────
String heartbeatJson(const char* caja, const char* estado) {
  StaticJsonDocument<200> doc;
  doc["caja"] = caja; doc["estado"] = estado;
  doc["uptime_s"] = (millis() - bootMs) / 1000;
  doc["rssi"] = WiFi.RSSI(); doc["heap"] = ESP.getFreeHeap();
  doc["a0"] = activo[0]; doc["a1"] = activo[1];
  String out; serializeJson(doc, out); return out;
}

void publicarEstado(const char* estado) {
  if (!mqtt.connected()) return;
  for (int i = 0; i < NUM_CANALES; i++)
    mqtt.publish(TOPIC_STATUS(i).c_str(), heartbeatJson(IDS[i], estado).c_str(), false);
}

void mqttCallback(char* topic, byte* payload, unsigned int len) {
  String msg; msg.reserve(len);
  for (unsigned int i = 0; i < len; i++) msg += (char)payload[i];
  Serial.printf("[MQTT] %s : %s\n", topic, msg.c_str());

  // que canal es este topic
  int canal = -1;
  for (int i = 0; i < NUM_CANALES; i++) if (TOPIC_CMD(i) == String(topic)) { canal = i; break; }
  if (canal < 0) return;

  StaticJsonDocument<256> doc;
  if (deserializeJson(doc, msg)) return;
  if (strcmp(doc["accion"] | "", "activar") != 0) return;
  String orden = String((const char*)(doc["pago_id"] | ""));
  int seg = doc["segundos"] | 0;
  if (orden.length() == 0 || seg <= 0) return;

  activarCanal(canal, seg, orden);
}

bool mqttConectar() {
  String clientId = "termopago-estacion01";
  // LWT en el canal 0 (una conexion = un LWT). El canal 1 usa el respaldo de
  // vencimiento del QR (15 min) si el equipo se cae de golpe.
  String willMsg = heartbeatJson(IDS[0], "offline");
  bool ok = mqtt.connect(clientId.c_str(), MQTT_USER, MQTT_PASS,
                         TOPIC_STATUS(0).c_str(), 1, false, willMsg.c_str(), false);
  if (ok) {
    Serial.println("[MQTT] conectado");
    for (int i = 0; i < NUM_CANALES; i++) mqtt.subscribe(TOPIC_CMD(i).c_str(), 1);
    publicarEstado("online");
    ultimoMqttOk = millis();
  } else {
    Serial.printf("[MQTT] fallo rc=%d\n", mqtt.state());
  }
  return ok;
}

void asegurarMqtt() {
  if (mqtt.connected()) { ultimoMqttOk = millis(); mqttCaidoDesde = 0; return; }
  if (mqttCaidoDesde == 0) mqttCaidoDesde = millis();   // primer loop sin broker
  if (millis() - ultimoIntentoMqtt < MQTT_RETRY_MS) return;
  ultimoIntentoMqtt = millis();
  uint32_t estuvoCaido = millis() - mqttCaidoDesde;
  if (mqttConectar()) {
    // Volvio el broker. Si el hueco fue largo, pudo haber entrado un pago que
    // el backend no nos pudo empujar: lo vamos a buscar por HTTP, que es un
    // camino independiente del broker. El GET bloquea, asi que lo hace el loop.
    if (estuvoCaido > RECUPERAR_TRAS_MS) {
      pedirPendientes = true;
      Serial.printf("[RECUP] volvio el broker tras %lus -> busco pagos sin entregar\n",
                    (unsigned long)(estuvoCaido / 1000));
    }
    mqttCaidoDesde = 0;
  }
}

// Pregunta al backend si quedo algun pago sin entregar en cada canal. Usa
// /orden/<caja>, el mismo endpoint de la recuperacion tras corte de luz: toma la
// orden 'pendiente' mas vieja (o el restante de una 'ejecutando') y la devuelve.
// A diferencia de resumeCanal() del arranque, esto pasa por activarCanal(), que
// deduplica y encola: aca el canal PUEDE estar corriendo algo.
void recuperarPendientes() {
  for (int i = 0; i < NUM_CANALES; i++) {
    watchdogFeed();
    // No preguntar lo que no vamos a poder atender: /orden NO es una
    // consulta inocente, el backend marca la orden como 'ejecutando' al
    // devolverla. Si despues activarCanal() la descarta por cola llena,
    // queda cobrada, sin entregar y FUERA del reembolso automatico, que
    // solo mira las 'pendiente'. Dejandola pendiente la agarra el proximo
    // intento, o el watchdog la devuelve.
    if (activo[i] && colaLen[i] >= MAX_COLA) {
      Serial.printf("[RECUP] %s con la cola llena -> no pido pendientes\n", IDS[i]);
      continue;
    }
    String body;
    if (!httpGet(String("https://") + BACKEND_HOST + "/orden/" + IDS[i], &body)) continue;
    StaticJsonDocument<300> doc;
    if (deserializeJson(doc, body)) continue;
    if (doc["encender"] != true) continue;
    int seg = doc["segundos"] | 0;
    String orden = String((const char*)(doc["orden_id"] | ""));
    if (seg > 5 && orden.length()) {
      Serial.printf("[RECUP] %s tenia un pago sin entregar (%ds, %s)\n",
                    IDS[i], seg, orden.c_str());
      activarCanal(i, seg, orden);
    }
  }
}

// ─── WiFi: portal + auto-lock de la radio (anti band-steering) ────
// El portal (WiFiManager) toma la red del cliente. La 1ra vez que conecta
// aprende la radio exacta (BSSID + canal) y la guarda; en los arranques
// siguientes reconecta CLAVADO a esa radio, para que un router doble banda
// (2.4/5GHz con la misma SSID) no lo salte de banda y lo cuelgue.
Preferences wifiPrefs;
static uint8_t lockedBssid[6];
static int32_t lockedChannel = 0;
static bool    haveLock      = false;

void cargarLock() {
  wifiPrefs.begin("wifiloc", true);
  size_t n = wifiPrefs.getBytes("bssid", lockedBssid, 6);
  lockedChannel = wifiPrefs.getInt("chan", 0);
  wifiPrefs.end();
  haveLock = (n == 6 && lockedChannel > 0);
}

void guardarLock() {
  uint8_t* b  = WiFi.BSSID();
  int32_t  ch = WiFi.channel();
  if (b == nullptr || ch <= 0) return;
  wifiPrefs.begin("wifiloc", false);
  wifiPrefs.putBytes("bssid", b, 6);
  wifiPrefs.putInt("chan", ch);
  wifiPrefs.end();
  memcpy(lockedBssid, b, 6);
  lockedChannel = ch;
  haveLock = true;
  Serial.printf("[WiFi] radio guardada: canal %d, BSSID %02X:%02X:%02X:%02X:%02X:%02X\n",
                (int)ch, b[0], b[1], b[2], b[3], b[4], b[5]);
}

void borrarLock() {
  wifiPrefs.begin("wifiloc", false);
  wifiPrefs.clear();
  wifiPrefs.end();
  haveLock = false;
  memset(lockedBssid, 0, 6);
  lockedChannel = 0;
}

void conectarWiFi() {
  WiFi.mode(WIFI_STA); WiFi.setSleep(false);
  WiFi.setAutoReconnect(true); WiFi.persistent(true);
  WiFiManager wm;
  String red  = wm.getWiFiSSID();
  String pass = wm.getWiFiPass();
  mostrar("Conectando WiFi", "Por favor espere");

  if (red.length() > 0) {
    cargarLock();
    unsigned long t0 = millis();
    if (haveLock) {
      // reconecta clavado a la radio aprendida
      WiFi.begin(red.c_str(), pass.c_str(), lockedChannel, lockedBssid);
      while (WiFi.status() != WL_CONNECTED && millis() - t0 < 18000) delay(250);
      if (WiFi.status() != WL_CONNECTED) {
        // esa radio no aparecio (router cambiado/reubicado): reintento libre y re-aprendo
        Serial.println("[WiFi] radio guardada no responde -> reintento libre");
        WiFi.begin(red.c_str(), pass.c_str());
        t0 = millis();
        while (WiFi.status() != WL_CONNECTED && millis() - t0 < 15000) delay(250);
        if (WiFi.status() == WL_CONNECTED) guardarLock();
      }
    } else {
      // primera conexion con red ya guardada: aprendo la radio
      WiFi.begin(red.c_str(), pass.c_str());
      while (WiFi.status() != WL_CONNECTED && millis() - t0 < 25000) delay(250);
      if (WiFi.status() == WL_CONNECTED) guardarLock();
    }
    if (WiFi.status() != WL_CONNECTED) { mostrar("Sin WiFi", "Reintentando..."); delay(1000); ESP.restart(); }
  } else {
    // sin red guardada -> portal de configuracion (AP con clave)
    wm.setConfigPortalTimeout(180);
    if (!wm.autoConnect("TermoPago-Est01", PORTAL_PASS)) { delay(1000); ESP.restart(); }
    guardarLock();   // recien configurado por portal: aprendo la radio
  }
  Serial.println("[WiFi] " + WiFi.localIP().toString());
}

void ventanaResetWiFi() {
  pinMode(0, INPUT_PULLUP);
  mostrar("Cambiar WiFi?", "Apriete BOOT 5s");
  unsigned long t0 = millis();
  while (millis() - t0 < 5000) {
    if (digitalRead(0) == LOW) {
      unsigned long t1 = millis();
      while (digitalRead(0) == LOW && millis() - t1 < 1000) delay(50);
      if (millis() - t1 >= 1000) { WiFiManager wm; wm.resetSettings(); borrarLock();
        mostrar("WiFi borrado", "Configure de nuevo"); delay(1500); ESP.restart(); }
    }
    delay(50);
  }
}

// ─── Setup ────────────────────────────────────────────────────────
// -- Hora por NTP: necesaria para validar el certificado TLS del broker.
// Si no la conseguimos, el que llama cae a setInsecure() para NO dejar el
// equipo sin conectar por un problema de reloj. Alimenta el watchdog mientras
// espera. Devuelve true si consiguio hora real (epoch > nov-2023).
bool sincronizarHora() {
  configTime(0, 0, "pool.ntp.org", "time.nist.gov");
  unsigned long t0 = millis();
  while (time(nullptr) < 1700000000UL && millis() - t0 < 10000) {
    delay(200);
    watchdogFeed();
  }
  return time(nullptr) > 1700000000UL;
}

void setup() {
  Serial.begin(115200);
  Serial2.begin(9600, SERIAL_8N1, LINK_RX, LINK_TX);   // enlace al esclavo Nano
  mostrar("Iniciando...", "Por favor espere");

  watchdogInit();
  ventanaResetWiFi();
  conectarWiFi();
  watchdogAddTask();        // recien ahora vigilamos el loop
  reportarBoot();

  // MQTT sobre TLS
  // TLS del broker: si tenemos hora, validamos el certificado (setCACert con
  // las raices ISRG X1/X2). Si NO hay hora (NTP caido), caemos a setInsecure()
  // para que el equipo se conecte igual -> el endurecimiento nunca lo aisla.
  if (sincronizarHora()) {
    espClient.setCACert(HIVEMQ_CA_BUNDLE);
    Serial.println("[TLS] hora OK -> valido el certificado del broker");
  } else {
    espClient.setInsecure();
    Serial.println("[TLS] sin hora NTP -> setInsecure (degradado, pero conecta)");
  }
  mqtt.setServer(MQTT_HOST, MQTT_PORT);
  mqtt.setKeepAlive(MQTT_KEEPALIVE_S);
  mqtt.setSocketTimeout(8);       // connect()/socket NO pueden colgarse mas de 8s (default PubSubClient = 15s, que empataba con el watchdog y disparaba task_wdt en reconexiones lentas al broker)
  mqtt.setBufferSize(512);
  mqtt.setCallback(mqttCallback);
  mqttConectar();

  // retomar servicios que quedaron a mitad por corte de luz
  for (int i = 0; i < NUM_CANALES; i++) resumeCanal(i);

  bootMs = millis();
  ultimoHeartbeat = millis();
}

// ─── Loop ─────────────────────────────────────────────────────────
void loop() {
  watchdogFeed();

  bool enServicio = activo[0] || activo[1];

  // Red de seguridad: reinicios SOLO en reposo (un reinicio del maestro no
  // corta el servicio -> el esclavo sostiene el rele; pero igual esperamos a
  // que termine para no perder el display ni la cola).
  if (!enServicio) {
    if (millis() - bootMs > SIN_COMM_TIMEOUT && millis() - ultimoMqttOk > SIN_COMM_TIMEOUT) {
      Serial.println("[SIN COMM] > 90s sin broker -> reinicio");
      mostrar("Reconectando", "Reiniciando..."); delay(300); ESP.restart();
    }
    if (ESP.getFreeHeap() < 40000) { Serial.println("[HEAP] bajo -> reinicio"); delay(200); ESP.restart(); }
    if (millis() - bootMs > REINICIO_PREVENT) {
      Serial.println("[PREVENTIVO] 6h -> reinicio"); mostrar("Mantenimiento", "Reiniciando..."); delay(300); ESP.restart();
    }
  }

  // WiFi caido: avisar y esperar auto-reconnect (el reinicio lo cubre el de arriba)
  if (WiFi.status() != WL_CONNECTED) { mostrar("WiFi perdido", "Reconectando..."); delay(200); return; }

  asegurarMqtt();
  mqtt.loop();

  // Volvimos de un corte del broker: ir a buscar lo que no nos pudieron empujar.
  if (pedirPendientes) { pedirPendientes = false; recuperarPendientes(); }

  // Timer paralelo: marca fin de servicio y agenda /completar (el rele lo apaga
  // el esclavo por su cuenta). Luego, si hay cola, activa el siguiente.
  for (int i = 0; i < NUM_CANALES; i++) {
    if (activo[i] && (long)(finMs[i] - millis()) <= 0) {
      activo[i] = false;
      pendienteCompletar[i] = ordenId[i];
      ordenId[i] = "";
      Serial.printf("[FIN] canal %d\n", i);
    }
    // activar el proximo de la cola cuando el canal quedo libre
    if (!activo[i] && colaLen[i] > 0) {
      String o = colaOrden[i][0]; int s = colaSeg[i][0];
      for (int k = 1; k < colaLen[i]; k++) { colaOrden[i][k-1] = colaOrden[i][k]; colaSeg[i][k-1] = colaSeg[i][k]; }
      colaLen[i]--;
      activarCanal(i, s, o);
    }
  }

  // Confirmar ordenes terminadas (HTTP puntual)
  for (int i = 0; i < NUM_CANALES; i++)
    if (pendienteCompletar[i] != "") { completarOrden(pendienteCompletar[i]); pendienteCompletar[i] = ""; }

  // Heartbeat cada 60s (los dos canales)
  if (millis() - ultimoHeartbeat >= HEARTBEAT_MS) { ultimoHeartbeat = millis(); publicarEstado("online"); }

  // Keepalive al esclavo cada 1s: mantiene vivo el enlace (evita el "Sin datos"
  // al terminar el servicio) y refresca el texto de reposo. Durante el servicio
  // el esclavo dibuja su propio contador e IGNORA este texto, pero igual mantiene
  // el enlace fresco -> al terminar muestra el reposo al toque.
  if (millis() - ultimoLcdMs >= 1000) {
    ultimoLcdMs = millis();
    mostrar(mqtt.connected() ? "WiFi conectado!" : "Conectando...", mqtt.connected() ? "Escanee el QR" : "al servidor...");
  }

  delay(20);
}
