marcospiana/termopago/firmware/nodemcu32_estacion01/nodemcu32_estacion01.ino

// TermoPago - Estación 01: Aspiradora + Soplador
// NodeMCU-32 / ESP32. Los dos servicios funcionan en paralelo
// (firmware no bloqueante con timers por canal).

#include <WiFi.h>
#include <HTTPClient.h>
#include <ArduinoJson.h>
#include <WiFiManager.h>
#include <Wire.h>
#include <hd44780.h>
#include <hd44780ioClass/hd44780_I2Cexp.h>
#include <esp_task_wdt.h>
#include <WiFiClientSecure.h>
// ── Watchdog RTC (dominio siempre-encendido). Reinicia el chip aunque el
//    task-watchdog no lo logre. Si NO compila, borrá esta linea y TODAS las
//    lineas marcadas con "// RTC-WDT" mas abajo, y volvé a flashear.
#include "rtc_wdt.h"

const char* BACKEND_BASE  = "https://web-production-94bbab.up.railway.app";
const int   WDT_TIMEOUT_S = 120;
const unsigned long INTERVALO_POLL_MS = 3000;

// ─── Canales ─────────────────────────────────────────────────────
const int NUM_CANALES = 2;
const char* IDS[NUM_CANALES]     = {"aspiradora01", "soplado01"};
const char* ETIQ[NUM_CANALES]    = {"Aspirad", "Soplado"};  // max 7 chars (LCD)
const int   RELAY_PIN[NUM_CANALES] = {25, 26};

bool          activo[NUM_CANALES]  = {false, false};
unsigned long finMs[NUM_CANALES]   = {0, 0};
String        ordenId[NUM_CANALES] = {"", ""};
String        pendienteCompletar[NUM_CANALES] = {"", ""};  // orden a confirmar luego

hd44780_I2Cexp lcd;
bool wifiConectadoMostrado = false;
unsigned long ultimoPollMs = 0;
unsigned long ultimoLcdMs  = 0;
int canalAPollear = 0;
unsigned long inicioCaidaMs = 0;      // cuándo empezó la caída de WiFi
unsigned long ultimoReintentoMs = 0;  // último WiFi.begin() forzado
unsigned long ultimoReinitLcdMs = 0;  // última re-inicialización del LCD
unsigned long ultimoPollOkMs = 0;     // último polling EXITOSO al backend
bool huboPollOk = false;              // ¿alguna vez conectó al server?
unsigned long reinitLcdEnMs = 0;      // reinit del LCD diferido (0 = nada pendiente)
unsigned long bootMs = 0;             // momento de arranque (margen anti reinicio falso)

// ─── LCD ─────────────────────────────────────────────────────────
void mostrarMensaje(String linea1, String linea2 = "") {
  lcd.clear();
  lcd.setCursor(0, 0);
  lcd.print(linea1);
  if (linea2 != "") {
    lcd.setCursor(0, 1);
    lcd.print(linea2);
  }
}

const char* NOMBRES[NUM_CANALES] = {"Aspiradora", "Soplador"};

String rellenar(String s) {
  while (s.length() < 16) s += " ";
  return s.substring(0, 16);
}

String tiempoRestante(int i) {
  long rest = (long)(finMs[i] - millis()) / 1000;
  if (rest < 0) rest = 0;
  int m  = rest / 60;
  int sg = rest % 60;
  if (m > 0) return String(m) + "m " + String(sg) + "s";
  return String(sg) + " seg";
}

String lcdCache[2] = {"", ""};

void refrescarLcd() {
  String l1, l2;
  // ¿el backend responde? si el WiFi conecta pero hace >25s que no hay
  // un polling exitoso, es señal débil / sin llegada al servidor.
  bool serverOk = huboPollOk && (millis() - ultimoPollOkMs < 25000);
  if (!activo[0] && !activo[1]) {
    if (serverOk) {
      l1 = "WiFi conectado!";
      l2 = "Escanee el QR";
    } else {
      l1 = "Sin conexion";
      l2 = "al servidor...";
    }
  } else if (activo[0] && !activo[1]) {
    l1 = NOMBRES[0];
    l2 = "Quedan " + tiempoRestante(0);
  } else if (!activo[0] && activo[1]) {
    l1 = NOMBRES[1];
    l2 = "Quedan " + tiempoRestante(1);
  } else {
    // los dos en uso a la vez: una línea para cada uno
    l1 = "Aspir: " + tiempoRestante(0);
    l2 = "Sopla: " + tiempoRestante(1);
  }
  l1 = rellenar(l1);
  l2 = rellenar(l2);
  // Solo reescribe una línea si cambió (evita parpadeo)
  if (l1 != lcdCache[0]) { lcdCache[0] = l1; lcd.setCursor(0, 0); lcd.print(l1); }
  if (l2 != lcdCache[1]) { lcdCache[1] = l2; lcd.setCursor(0, 1); lcd.print(l2); }
}

void invalidarLcd() {
  lcdCache[0] = "";
  lcdCache[1] = "";
}

// Re-inicializa el LCD. El ruido del rele puede corromper el controlador
// (queda ilegible); esto lo restaura sin reiniciar la placa.
// Redibuja al instante para que no quede la pantalla en blanco.
void reiniciarLcd() {
  lcd.begin(16, 2);
  lcd.backlight();
  invalidarLcd();
  refrescarLcd();   // vuelve a escribir el contenido de inmediato
}

// ─── Watchdog ────────────────────────────────────────────────────
void iniciarWatchdog() {
#if defined(ESP_ARDUINO_VERSION_MAJOR) && ESP_ARDUINO_VERSION_MAJOR >= 3
  esp_task_wdt_deinit();
  esp_task_wdt_config_t wdt_config = {
    .timeout_ms = WDT_TIMEOUT_S * 1000,
    .idle_core_mask = 0,
    .trigger_panic = true
  };
  esp_task_wdt_init(&wdt_config);
#else
  esp_task_wdt_init(WDT_TIMEOUT_S, true);
#endif
  esp_task_wdt_add(NULL);

  // ── RTC-WDT: watchdog en el dominio RTC (siempre encendido). Es el que
  //    de verdad reinicia si el chip se cuelga y el task-watchdog no responde.
  //    Timeout 60 s. Si esto no compila, borrá este bloque y el include de
  //    arriba y volvé a flashear (el resto de las mejoras siguen valiendo).
  rtc_wdt_protect_off();                                              // RTC-WDT
  rtc_wdt_set_stage(RTC_WDT_STAGE0, RTC_WDT_STAGE_ACTION_RESET_SYSTEM); // RTC-WDT
  rtc_wdt_set_time(RTC_WDT_STAGE0, 60000);                           // RTC-WDT
  rtc_wdt_enable();                                                  // RTC-WDT
  rtc_wdt_protect_on();                                              // RTC-WDT
}

// ─── Backend ─────────────────────────────────────────────────────
void completarOrden(String id) {
  if (id == "") return;
  for (int intento = 0; intento < 3; intento++) {
    esp_task_wdt_reset();
    WiFiClientSecure client;
    client.setInsecure();   // sin validar certificado: menos RAM y sin cuelgues de TLS
    HTTPClient http;
    http.begin(client, String(BACKEND_BASE) + "/completar/" + id);
    http.setConnectTimeout(4000);  // acota el intento de conexion (server caido)
    http.setTimeout(5000);
    int code = http.GET();
    http.end();
    if (code == 200) {
      Serial.println("Orden completada: " + id);
      return;
    }
    delay(2000);
  }
  Serial.println("No se pudo confirmar (el backend la expira solo)");
}

void pollearCanal(int i) {
  esp_task_wdt_reset();
  WiFiClientSecure client;
  client.setInsecure();   // sin validar certificado: menos RAM y sin cuelgues de TLS
  HTTPClient http;
  http.begin(client, String(BACKEND_BASE) + "/orden/" + IDS[i]);
  http.setConnectTimeout(4000);  // acota el intento de conexion (server caido)
  http.setTimeout(5000);
  int code = http.GET();

  if (code == 200) {
    ultimoPollOkMs = millis();   // el backend respondio: conexion OK
    huboPollOk = true;
    StaticJsonDocument<300> doc;
    DeserializationError error = deserializeJson(doc, http.getString());
    if (!error && doc["encender"] == true) {
      int segundos = doc["segundos"];
      ordenId[i] = String((const char*)(doc["orden_id"] | ""));
      activo[i] = true;
      finMs[i] = millis() + (unsigned long)segundos * 1000UL;
      digitalWrite(RELAY_PIN[i], LOW);  // encender
      invalidarLcd();               // solo marca cache (no toca I2C ahora)
      reinitLcdEnMs = millis() + 250;  // reinit del LCD 250ms despues, con el ruido ya pasado
      Serial.println(String(ETIQ[i]) + " ON por " + String(segundos) + "s (orden " + ordenId[i] + ")");
    }
  } else {
    Serial.println("Error HTTP " + String(IDS[i]) + ": " + String(code));
  }
  http.end();
}

// ─── Setup ───────────────────────────────────────────────────────
void setup() {
  Serial.begin(115200);

  for (int i = 0; i < NUM_CANALES; i++) {
    pinMode(RELAY_PIN[i], OUTPUT);
    digitalWrite(RELAY_PIN[i], HIGH);  // apagados por defecto
  }

  Wire.begin(21, 22);
  Wire.setTimeOut(50);   // el I2C se corta a los 50ms en vez de colgar el micro
  Wire.setClock(50000);   // I2C mas lento: aguanta mejor el cable de 2m al display
                         // si el ruido del rele deja el bus trabado (SDA pegada)
  lcd.begin(16, 2);
  lcd.backlight();
  mostrarMensaje("Iniciando...", "Por favor espere");

  // ── Reset de WiFi: al ENCENDER NORMAL (sin apretar nada), hay una
  //    ventana de 5 seg para apretar BOOT y borrar la red guardada.
  //    (No apretar BOOT al prender: eso mete al ESP en modo grabacion.)
  pinMode(0, INPUT_PULLUP);
  mostrarMensaje("Cambiar WiFi?", "Apriete BOOT 5s");
  { unsigned long t0 = millis(); bool reset = false;
    while (millis() - t0 < 5000) {
      if (digitalRead(0) == LOW) {          // BOOT apretado durante la ventana
        unsigned long t1 = millis();
        while (digitalRead(0) == LOW && millis() - t1 < 1000) delay(50);
        if (millis() - t1 >= 1000) { reset = true; break; }
      }
      delay(50);
    }
    if (reset) {
      WiFiManager wm;
      wm.resetSettings();                   // olvida la red guardada
      mostrarMensaje("WiFi borrado", "Configure de nuevo");
      delay(1500);
    }
  }

  WiFi.mode(WIFI_STA);
  WiFi.setSleep(false);  // sin ahorro de energía: elimina los picos de corriente
                         // periódicos del radio que hacen parpadear el LCD
  WiFi.setAutoReconnect(true);
  WiFi.persistent(true);

  mostrarMensaje("Conectando WiFi", "Por favor espere");

  WiFiManager wifiManager;
  wifiManager.setConfigPortalTimeout(180);
  if (!wifiManager.autoConnect("TermoPago-Est01")) {
    mostrarMensaje("Error WiFi", "Reiniciando...");
    delay(3000);
    ESP.restart();
  }

  Serial.println("WiFi conectado: " + WiFi.localIP().toString());
  wifiConectadoMostrado = true;
  lcd.clear();

  bootMs = millis();  // referencia de arranque; ultimoPollOkMs queda en 0 hasta
                      // que HAYA un poll real (asi el display no miente al prender)
  iniciarWatchdog();
}

// ─── Loop principal (no bloqueante) ──────────────────────────────
void loop() {
  esp_task_wdt_reset();
  rtc_wdt_feed();   // RTC-WDT: alimentar el watchdog RTC (borrar si no compila)

  // 0. Redes de seguridad SOLO con las dos máquinas apagadas (no cortar un
  //    servicio pago). Recuperan cuelgues "blandos" donde el loop sigue vivo.
  if (!activo[0] && !activo[1]) {
    // a) heap bajo => fuga de memoria; reiniciar antes de que crashee
    if (ESP.getFreeHeap() < 40000) {
      Serial.println("Heap bajo, reiniciando preventivamente...");
      delay(200);
      ESP.restart();
    }
    // b) Sin llegar al server hace 2 min estando en reposo, sea cual sea el
    //    motivo (WiFi caido, "conectando" eterno, flapping, enlace zombie,
    //    o nunca conecto desde el arranque): reiniciar SIEMPRE. Sin condicion
    //    de huboPollOk, para que no quede atrapado como paso recien.
    //    En reposo no hay servicio pago que cortar.
    if (millis() - bootMs > 120000 && millis() - ultimoPollOkMs > 120000) {
      Serial.println("Sin llegar al server 2min (idle), reiniciando...");
      delay(200);
      ESP.restart();
    }
  }

  // 1. Apagar canales cuyo tiempo terminó.
  //    IMPORTANTE: el apagado tiene que ser INSTANTANEO. Justo aca la bobina
  //    del contactor se desenergiza y genera el mayor pico inductivo (fue el
  //    momento exacto en que se colgo). NO hacemos la llamada HTTP de
  //    /completar aca: la dejamos pendiente y se confirma en el ciclo
  //    siguiente, con el transitorio ya pasado y sin bloquear en el peor
  //    instante.
  for (int i = 0; i < NUM_CANALES; i++) {
    if (activo[i] && (long)(finMs[i] - millis()) <= 0) {
      digitalWrite(RELAY_PIN[i], HIGH);  // apagar (instantaneo)
      activo[i] = false;
      pendienteCompletar[i] = ordenId[i];  // confirmar despues, no aca
      ordenId[i] = "";
      Serial.println(String(ETIQ[i]) + " OFF");
      invalidarLcd();               // solo marca cache (no toca I2C ahora)
      reinitLcdEnMs = millis() + 250;  // reinit del LCD 250ms despues, con el ruido ya pasado
    }
  }

  // 2. WiFi caido: SIMPLE y robusto. NO tocamos el driver a la fuerza
  //    (el disconnect()/begin() en bucle lo trababa y colgaba el loop).
  //    Dejamos que el auto-reconnect del driver trabaje solo; si no vuelve
  //    en 60s, reinicio LIMPIO (el reboot reconecta de cero, sin wedge).
  if (WiFi.status() != WL_CONNECTED) {
    if (wifiConectadoMostrado) {
      wifiConectadoMostrado = false;
      inicioCaidaMs = millis();       // marca cuándo empezó la caída
      mostrarMensaje("WiFi perdido", "Reconectando...");
      invalidarLcd();
      Serial.println("WiFi perdido...");
    }
    if (millis() - inicioCaidaMs >= 60000) {   // 60s sin WiFi => reboot limpio
      mostrarMensaje("Sin WiFi", "Reiniciando...");
      Serial.println("WiFi caido 60s, reiniciando...");
      delay(500);
      ESP.restart();
    }
    // los servicios activos siguen corriendo aunque no haya WiFi
    delay(200);
    return;
  }
  if (!wifiConectadoMostrado) {
    wifiConectadoMostrado = true;
    lcd.clear();
    invalidarLcd();
    Serial.println("WiFi reconectado: " + WiFi.localIP().toString());
  }

  // 2b. Confirmar al backend las ordenes que terminaron (fuera del momento
  //     critico del apagado; aca ya hay WiFi y el pico inductivo ya paso).
  for (int i = 0; i < NUM_CANALES; i++) {
    if (pendienteCompletar[i] != "") {
      completarOrden(pendienteCompletar[i]);
      pendienteCompletar[i] = "";
    }
  }

  // 3. Polling: en cada ciclo pregunta por TODOS los canales inactivos
  //    (los dos juntos), asi ambos quedan al dia en el mismo momento.
  if (millis() - ultimoPollMs >= INTERVALO_POLL_MS) {
    ultimoPollMs = millis();
    for (int i = 0; i < NUM_CANALES; i++) {
      if (!activo[i]) pollearCanal(i);
    }
  }

  // 4. LCD cada 1 segundo
  if (millis() - ultimoLcdMs >= 1000) {
    ultimoLcdMs = millis();
    refrescarLcd();
  }

  // 4b. Reinit del LCD diferido: se programa al conmutar un rele y se ejecuta
  //     250ms despues, con el pico de ruido ya pasado (evita colgar el I2C).
  if (reinitLcdEnMs && millis() >= reinitLcdEnMs) {
    reinitLcdEnMs = 0;
    reiniciarLcd();
  }

  // 5. Re-inicializacion periodica de seguridad (cada 5 min): red de
  //    seguridad minima. El ruido real se cubre al encender/apagar el rele.
  if (millis() - ultimoReinitLcdMs >= 300000) {
    ultimoReinitLcdMs = millis();
    reiniciarLcd();
  }

  delay(50);
}
