marcospiana/termopago/(commit log)

2026-05-25 agrego base de datos
2026-05-25 excluir mas metodos de pago
2026-07-10 fix ver_sucursales + setup QR punto de venta
2026-07-10 panel de configuracion de precio y tiempo
2026-07-10 recuperacion de pagos y ordenes interrumpidas
2026-07-11 reembolso automatico de pagos no atendidos
2026-07-12 ventana de QR a 30 min con renovacion cada 20
2026-07-13 estadisticas de ventas por mes y maquina
2026-08-01 ventana de QR a 15 min con re-armado cada 10
2026-08-04 config: re-armar QR tambien al cambiar el tiempo
2026-08-04 fechas en horario de Argentina (UTC-3)
2026-08-04 historial: mostrar id de la maquina (estacion 01/02)
2026-08-04 landing publica en la ruta raiz
2026-08-04 display muestra Sin conexion al server cuando no llega a Railway
2026-08-04 pagina de estado de equipos (conectado/caido)
2026-08-05 landing modo proximamente, solo email
2026-08-05 logo real integrado a la landing + favicon
2026-08-05 QR realista con rayo en el mockup del celular
2026-08-05 contacto: boton que copia el mail al portapapeles
2026-08-05 nuevo titulo hero: la maquina cobra y se activa sola
2026-08-05 logo con estilo QR matcheando el del celular + hero nuevo
2026-08-05 logo opcion B: QR + boton de encendido, borde gris
2026-08-05 power button coherente en logo y celular
2026-08-05 correcciones de copy: fichas coherente, respaldo por fichas, interoperabilidad, voseo
2026-08-05 reorganizacion de carpetas y limpieza del repo
    [bezel_compacto.stl, bezel_frontal.stl, bezel_mini.stl, carcasa_frente.stl, tapa_compacta.stl, tapa_trasera.stl]
2026-08-05 reset de wifi con boton BOOT al encender
    [nodemcu32_aspiradora_soplado.ino, nodemcu32_estacion02.ino]
2026-08-05 reset wifi: ventana de 5s con BOOT al arrancar (no al encender)
    [nodemcu32_aspiradora_soplado.ino, nodemcu32_estacion02.ino]
2026-08-05 pagina de cortes de conexion (huecos mayores a 30s)
2026-08-05 polling de ambos canales en el mismo ciclo + pagina de cortes
2026-08-05 agregar cortes al doc de enlaces
2026-08-06 cortes: no contar el hueco cuando la maquina estuvo andando
2026-08-28 fix /reinicios: mostrar los reinicios recientes (antes traia los mas viejos)
    [estacion01_maestro.ino, estacion02_maestro.ino]
2026-08-28 inflado01: activacion MQTT en webhook + suscriptor MQTT para estado/cortes + firmware
    Nueva estacion inflado01 (single ESP32, MQTT push, pulso 300ms). Backend: publicar_activacion via paho al confirmar pago y marcar orden completada; suscriptor MQTT (advisory-lock) que lee el heartbeat y actualiza ultimo_poll + cortes. .gitignore ignora *_privado.h.
    Claude-Session: https://claude.ai/code/session_01MDVtW795ohPKMyuDnXzCv8
2026-08-28 backend: MQTT_PORT/HOST/USER vacios no tumban el arranque (default/None)
    Una env var MQTT vacia hacia crashear gunicorn en int(''); ahora cae al default 8883 o se ignora. Robustez para no tirar abajo el backend de pagos por una config MQTT incompleta.
    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
2026-08-28 simular_pago: activar por MQTT las cajas de pulso (inflado)
    Antes /simular_pago solo creaba una orden pendiente (que las cajas de polling levantan). Para cajas MQTT (inflado01) ahora publica la activacion y marca la orden completada, para poder simular pagos igual que aspiradora.
    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
2026-08-28 inflado: el heartbeat MQTT re-arma el QR (la orden no vence mas)
    Las cajas de pulso no pollean /orden, asi que nadie les renovaba la orden del QR (expira a los 15 min) y el QR quedaba impagable. Ahora el suscriptor, en cada heartbeat, re-arma el QR si el ultimo rearme supera los 10 min. Igual criterio que /orden para las cajas de polling.
    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
2026-08-28 inflado: cancelar el QR cuando el equipo esta offline (LWT)
    Si el equipo de pulso se cae, el LWT 'offline' hace que el backend cancele la orden del QR para que nadie pague una maquina que no va a responder. Al volver, el heartbeat re-arma el QR solo. Backstop: sin heartbeats la orden vence igual en <=15 min.
    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
2026-08-28 crear_dispositivo: actualizar la cuenta (token_env) si el dispositivo ya existe
    Permite re-apuntar un dispositivo a otra cuenta de MercadoPago re-corriendo el alta con el token correcto. Antes solo seteaba token_env al crear, asi que inflado01 (creado sin token) quedaba fijo en la cuenta propia y su QR no cobraba. Limpia la orden vieja al re-apuntar.
    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
2026-08-29 inflado: conteo editable desde /config (segundos por MQTT) + pantalla vuelve a espera
    Backend: publicar_activacion manda 'segundos' (de la caja) en el cmd; /config edita el tiempo de las cajas de pulso en SEGUNDOS. Firmware: el conteo usa los segundos del cmd (CICLO_SEGUNDOS pasa a ser solo el default) y la pantalla vuelve sola a 'WiFi conectado / Escanea el QR' tras el servicio.
    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
2026-08-29 inflado: cola de pagos + no reiniciar durante el servicio
    Cola FIFO (hasta 5) con dedup: un pago durante el conteo espera su turno. Y los reinicios por sin-comunicacion (MQTT>90s) y heap bajo (umbral blando 20k) ahora esperan a que termine el conteo; solo un OOM critico (<10k) o el watchdog reinician en servicio. El pulso ya salio, asi que un reinicio no le corta el servicio al cliente (la maquina corre sola).
    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
2026-08-29 estacion01: migracion a MQTT (backend) + maestro MQTT (borrador) + borrar esclavo ESP8266
    Backend: aspiradora01/soplado01 pasan a cajas MQTT (activacion push + re-armado de QR por heartbeat). Servicio sostenido -> orden 'ejecutando' con inicio (recuperacion calcula el restante); pulso (inflado) sigue 'completada'. publicar_activacion recibe el id completo de la orden (coincide con /orden). Compatible con el maestro viejo de polling durante la transicion. Firmware: nuevo maestro MQTT como archivo aparte (rollback). Borrado el esclavo ESP8266 obsoleto (estacion01 usa Nano).
    Claude-Session: https://claude.ai/code/session_01MDVtW795ohPKMy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
2026-08-29 simular_pago manda el tiempo de la URL al ESP (override); pagos reales siguen usando config
2026-08-29 offline de una caja cancela el QR de todas las del mismo ESP (aspiradora01+soplado01)
2026-08-29 rearmar_qr: si falla crear la orden nueva, reintenta al proximo heartbeat (60s) en vez de dejar el QR muerto 10min
2026-08-31 firmware: reinicio preventivo 6h en maestros viejos + keepalive al Nano (Sin datos); sumo cartel, QR y docs de inflado
    [estacion01_maestro.ino, estacion01_maestro_mqtt.ino, estacion02_maestro.ino]
2026-08-31 enlaces: agrego inflado01, alertas Telegram, firmware MQTT de estacion01 y actualizo como funciona
2026-08-31 endpoint /health para monitoreo externo (chequea backend + DB)
2026-08-31 TLS endurecido: valido cert del broker (ISRG X1/X2) con NTP y fallback a setInsecure; ca_hivemq.h en inflado01 y estacion01
    [ca_hivemq.h, estacion01_maestro_mqtt.ino, inflado01.ino]
2026-09-01 endpoint /reinicios_reset para limpiar el historial de reinicios
2026-09-01 subscriptor re-arma el QR apenas ve heartbeat online si quedo cancelado (arregla aspiradora02 trabada tras offline)
2026-09-01 subscriptor ignora offline retenido (msg.retain): arregla aspiradora02 que se re-cancelaba sola tras cada reconexion del backend
2026-09-01 diag_caja: compara external_pos_id con la caja MP real y estado de la orden (debug aspiradora02)
2026-09-01 diag_caja: agrega pagos recientes para detectar pago trabado en proceso
2026-09-02 diag_caja: agrega store_id (sucursal) para comparar cajas rotas vs sanas
2026-09-02 rearmar_qr: borra la orden vieja de la caja (Instore DELETE) antes de crear la nueva - arregla QR trabado en registrando tras un pago
2026-09-02 re-armado de QR configurable, default 4min (antes 10) para que no se muera a los 8min
2026-09-06 Agregar /oauth_estado: ruta de diagnostico del marketplace OAuth
    Muestra si MP_CLIENT_ID/MP_CLIENT_SECRET/FEE_PORCENTAJE estan cargados,
    el redirect_uri a registrar en MP, y el estado de cada cliente conectado
    y sus cajas. No expone secretos.
    Claude-Session: https://claude.ai/code/session_018iXu5kpSSFNHJAttfJ8tmZ
2026-09-06 Panel propio por cliente: /panel/<token> (ve y edita solo lo suyo)
    Cada cliente OAuth tiene un link secreto (panel_token) con su panel
    mobile-first: estado de conexion, ventas/estadisticas, historial, y
    edicion de su propio precio/tiempo (re-arma el QR). Filtra todo por
    'cliente' -> nunca ve datos de otras estaciones ni usa la clave maestra.
    Admin genera el link con /panel_link/<clave>/<alias>.
    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
2026-09-07 Soporte de expendedora de fichas (villagas01) por MQTT
    Nueva caja tipo fichas: se activa por push MQTT como estacion de pulso,
    pero el cmd lleva 'cantidad' de fichas (no 'segundos'). El campo segundos
    del dispositivo guarda las fichas por pago (default 1 al crear). /config y
    el panel del cliente muestran 'Fichas por pago'. El firmware entrega N
    pulsos al COIN de la placa Electrolacer con dedup por pago.
    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
2026-09-07 Panel cliente: regalar ficha con PIN + tests fuera de stats
    El cliente regala 1 ficha desde su panel validando un PIN propio
    (clientes.pin, se genera y se muestra en /panel_link). El regalo se
    registra como orden 'gift_' -> no cuenta como venta; el panel muestra
    cuantas regalo en el mes y exige la maquina online. Las pruebas por
    /simular_pago usan un id sin prefijo real, asi que ya no entran en las
    estadisticas del cliente.
    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
2026-09-07 Panel del cliente: solo regalar; precio/cantidad de solo lectura
    El cliente ya no puede editar precio ni tiempo/fichas desde su panel:
    esos campos son solo-lectura (los ajusta el admin desde /config). El
    panel queda con estado, ventas, regalar-ficha-con-PIN e historial.
    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
2026-09-08 Panel: las fichas regaladas aparecen en el historial (dia/hora), sin facturar
    Las ordenes gift_ ahora se listan en 'Ultimas ventas' con fecha y hora,
    marcadas como '🎁 Regalo'. Se siguen excluyendo de los totales facturados
    (no cuentan como plata).
    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
2026-09-08 Panel: cuadro separado de 'Fichas regaladas' (mismo formato que ventas)
    Las regaladas salen del cuadro de ventas y tienen su propia tabla con Dia,
    Hora y Maquina. Ventas queda solo con pagos reales; regaladas no facturan.
    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
2026-09-08 subscriptor ignora TODO mensaje retenido (no solo offline): evita falsos online/offline y timestamps de contacto erroneos en las alertas
2026-09-08 QR fichas: descripcion del pago 'Ficha x N' (en vez del nombre de la maquina)
    Para las cajas de fichas, el title/description de la orden MP pasa a
    'Ficha x <cantidad>' (ej 'Ficha x 1'), asi el cliente ve el concepto al
    escanear. El nombre del comercio (ej YPF) lo pone la cuenta MP, no cambia.
    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
2026-09-10 Panel /admin: alta de clientes y maquinas sin tocar codigo
2026-09-10 Fix: el boton de conectar MercadoPago salia azul sobre azul
2026-09-10 La ficha de la maquina muestra el QR para imprimir
2026-09-10 Baja de clientes desde el panel
2026-09-10 Link de volver al panel en todas las paginas de admin
2026-09-10 Renovar PIN y link del panel del cliente
2026-09-10 Freno de fuerza bruta en el PIN del panel del cliente
2026-09-10 Telegram: identificar la caja (aspiradora01/02, soplado01/02) en los avisos
2026-09-25 Alertas Telegram: recordatorio periodico si un equipo sigue caido + reset robusto
    Antes: un equipo avisaba UNA vez al caer y nunca mas, asi una maquina caida
    dias pasaba desapercibida (ej villagas01 17 dias). Ahora: recordatorio cada
    RECORDATORIO_CAIDO_S (default 6h) mientras siga caida, y el reset de la bandera
    'ya avise' se limpia apenas vuelve (sin la zona muerta 90-180s de antes).
    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
2026-09-25 Telegram: volver al aviso simple (uno al caer, uno al volver, sin recordatorios)
    Marcos prefiere una sola notificacion al caer y nada mas hasta que se reconecta.
    Se saca el recordatorio periodico pero se MANTIENE el reset robusto de la bandera
    (sin la zona muerta 90-180s), que arreglaba el bug de no avisar al apagar estacion01.
    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
2026-09-25 Alertas Telegram: persistir el estado 'caido' en la DB (columna alerta_caido)
    Antes el estado vivia en RAM: al deployar/reiniciar se perdia, entonces no
    llegaba el 'volvio a estar online' y se repetia el 'se cayo' en cada deploy.
    Ahora se guarda en dispositivos.alerta_caido -> el aviso de caida/vuelta es
    confiable aunque el backend se reinicie.
    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
2026-09-25 Diagnostico de alertas: /diag_alertas + latido del vigilante en config
    Para saber por que no llegan los avisos: el vigilante ahora escribe un
    'vigilante_latido' cada vuelta, y /diag_alertas/<clave> muestra si el hilo
    esta vivo, si Telegram esta configurado, y el gap/caido/alerta_caido por caja.
    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
2026-09-25 Fix: el vigilante de alertas moria si no tomaba el advisory lock al primer intento
    Causa raiz de 'Telegram dejo de avisar': tras un deploy, el contenedor viejo
    retiene el lock 918273646 unos segundos; el vigilante lo intentaba UNA vez y
    hacia return -> quedaba muerto toda la vida del deploy. Ahora reintenta cada
    30s hasta conseguirlo. (El subscriptor de liveness no tenia este problema.)
    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
2026-10-06 Expendedora de fichas: dispensador de 2 reles (COIN + BOTON) con verificacion por sensor
2026-10-06 Saco un pptx que se habia guardado por error en qr/
2026-10-06 Fichas: pulsos por ficha configurables desde /config (credito de la placa / valor del pulso)
2026-10-06 Panel: el refresh reenviaba el POST y regalaba fichas de mas (PRG + cooldown + escape del mensaje)
2026-10-06 Fichas: ventana de recuperacion de 7 s desde el boton (sin eso se pierden los pulsos de la ficha siguiente)
2026-10-06 Fichas: espera de 1 s antes del boton, para ver el credito cargado
2026-10-06 QR: el titulo del pago lleva el nombre del comercio (Ficha x 1 <local>)
2026-10-08 Panel: dos codigos (regalo / premio por carga) y exportacion a Excel con rango de fechas
2026-10-08 Panel: unificar las consultas de ordenes (el LIKE con escape no matcheaba en SQLite)
2026-10-08 Firmware: lock automatico de radio WiFi (anti band-steering), clave en el portal y estado MQTT sin retain
2026-10-08 Prueba de la maquina de estados del dispensador (corre en la PC)
2026-10-08 Fichas: tope por pago de 20 a 5 + prueba de la maquina de estados
2026-10-08 Config: mostrar con cuantos pulsos por ficha esta trabajando la caja (del heartbeat)
2026-10-08 Panel: subir Entregar una ficha arriba de Ventas
2026-10-14 Admin: redirect despues del POST (un F5 regeneraba codigos) + fecha de cambio de cada codigo
2026-10-14 LWT rancio no cancela QR vivos; aviso unico cuando el suscriptor queda sordo
2026-10-14 Reintentar pagos que no se pudieron despachar y reembolsar los que nunca se entregaron
2026-10-22 Panel: cuadro de fichas sin cargo por dia, abierto por motivo
2026-10-22 Firmware: socket de PubSubClient a 8s y watchdog a 30s; estacion01 recupera pagos tras corte del broker sin pedir lo que no puede encolar
2026-10-23 Probar el webhook de Railway
2026-10-23 Admin: mostrar que commit esta corriendo y hace cuanto se desplego
2026-10-23 Panel: etiqueta Premio a secas para que entre en el telefono; el BOOT ya no borra el ID de caja
